stefantquach/steDAC/README.md

# SteDAC

Open source audio DAC project based on the ES9038Q2M DAC from ESS. Still WIP

# Credits
Logo art by @yumightaswell (Instagram)
