stefantquach/steDAC/panels/front_panel2_colored.dxf

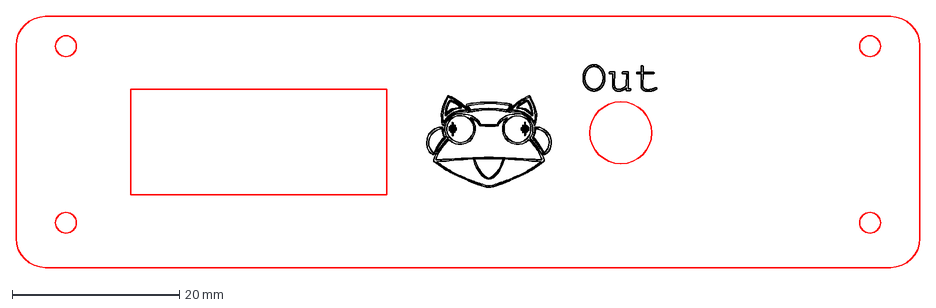
[picture p1: CAD file, 2022-07-17]
panels/front_panel2_colored.dxf
108.0 x 30.0 mm
