stefantquach/steDAC/panels/back_panel2_colored.dxf

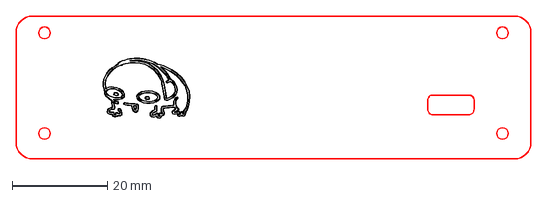
[picture p2: CAD file, 2022-07-17]
panels/back_panel2_colored.dxf
108.0 x 30.0 mm
