stefantquach/steDAC/KiCAD/pdf_sch/steDAC.pdf

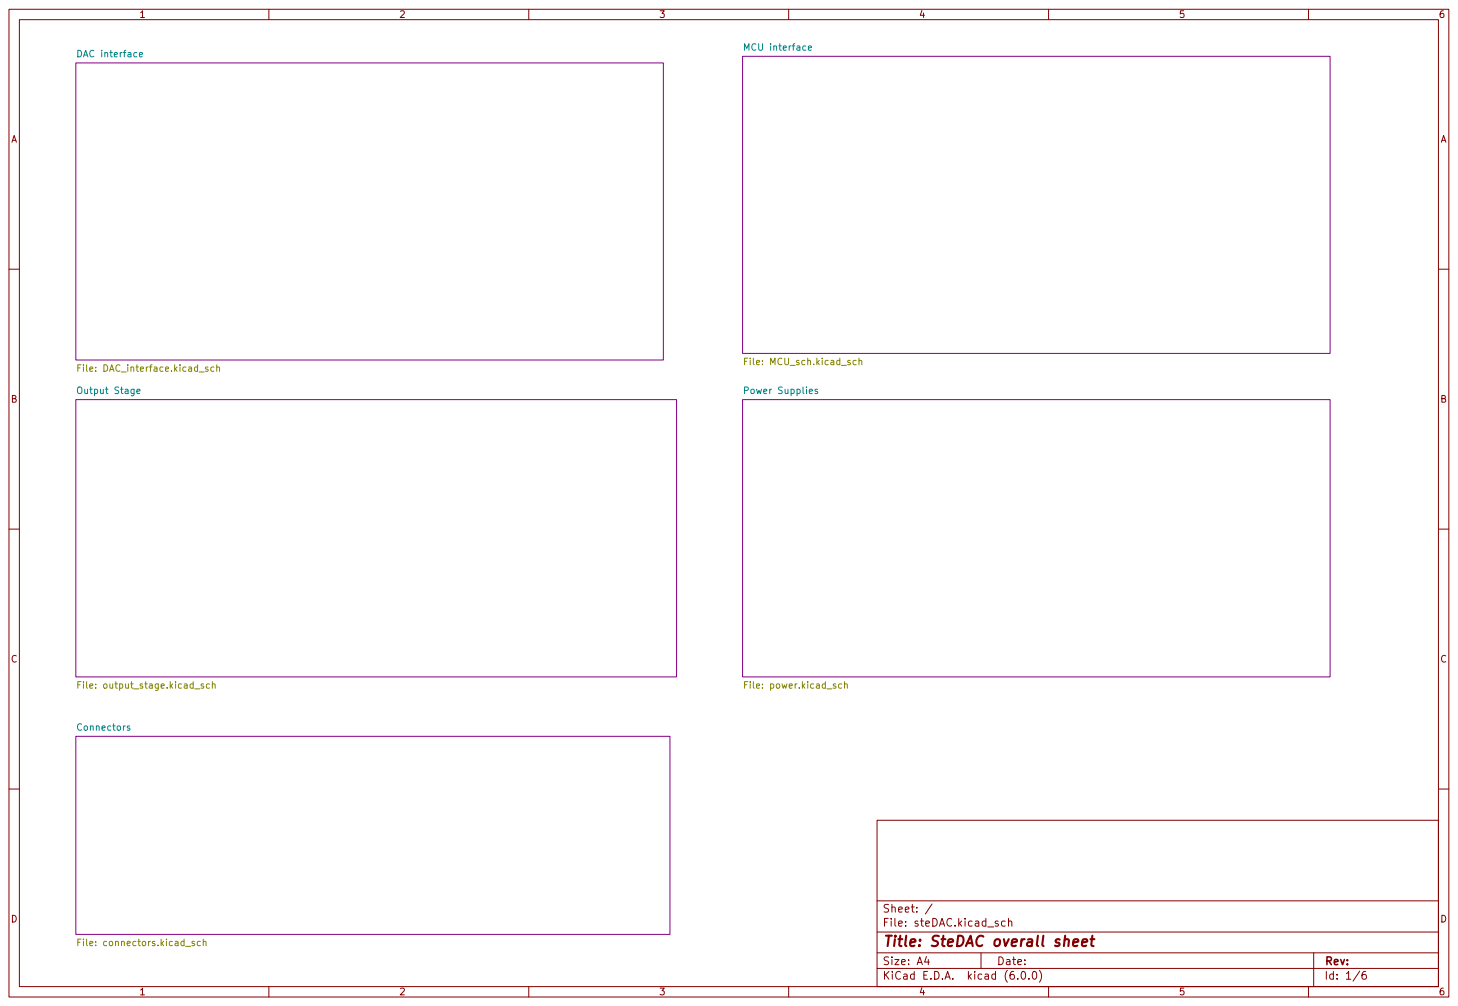
[picture p3: page 1]

MCU interface File: MCU_sch.kicad_sch Output Stage

File: output_stage.kicad_sch Connectors File: connectors.kicad_sch

File: steDAC.kicad_sch Sheet: /
Id: 1/6 Title: SteDAC overall sheet

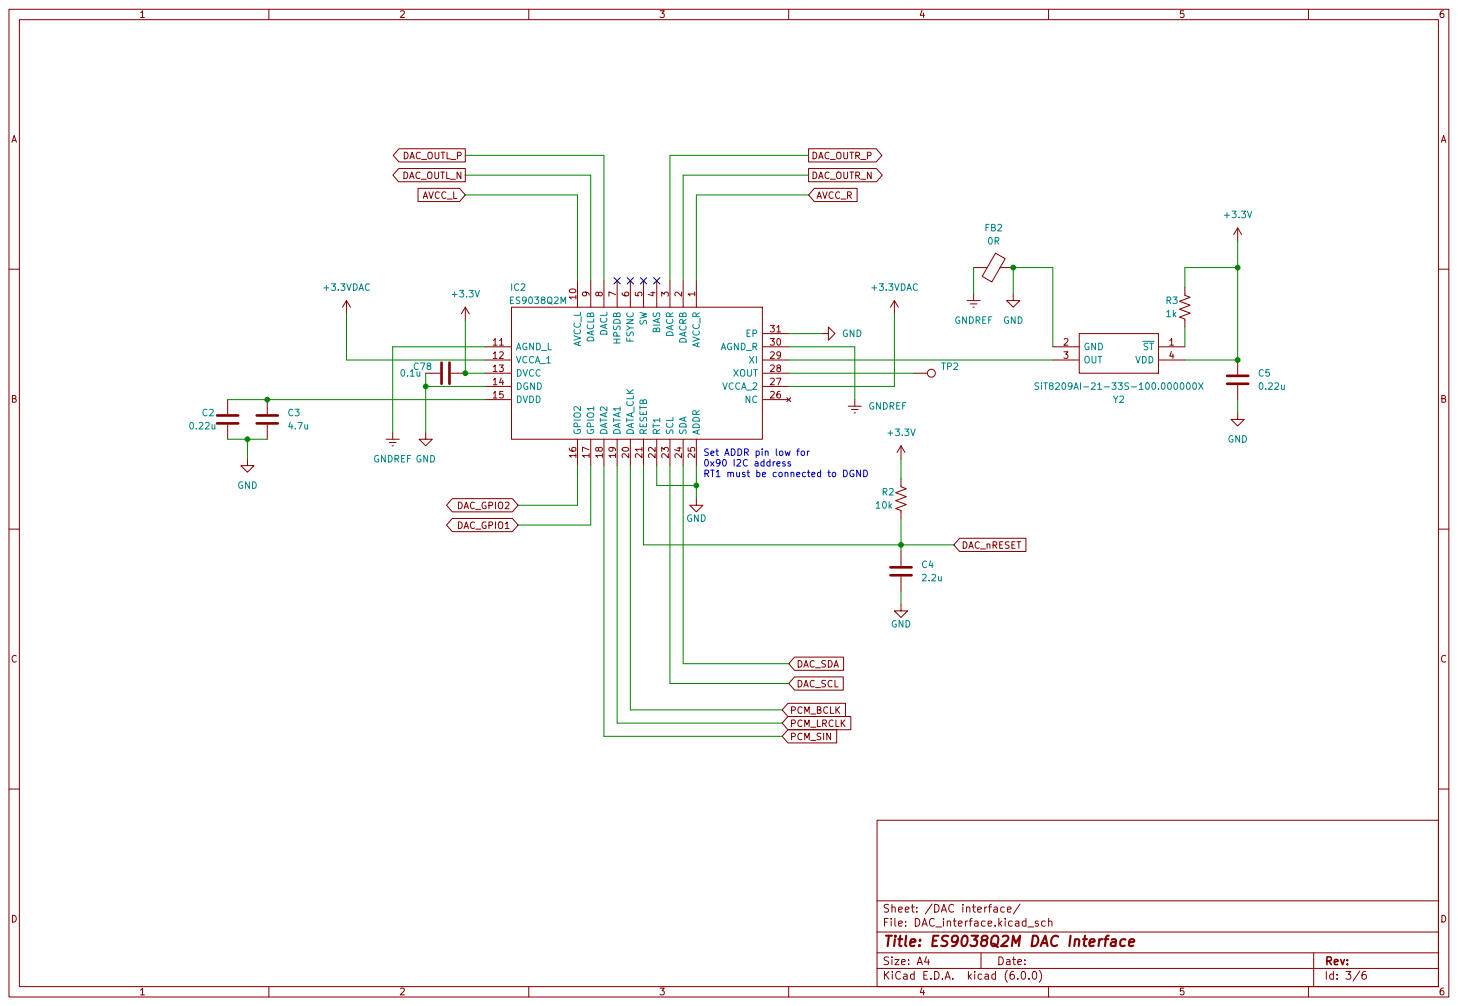
[picture p4: page 2]

1 AVCC_L 10 AGND_L 11 VCCA_1 12 DVCC 13 DGND 14 DVDD 15 GPIO2 16 GPIO1 17 DATA2 18 DATA1 19 DACRB

2 DATA_CLK 20 RESETB 21 RT1 22 SCL 23 SDA 24 ADDR 25 NC 26 VCCA_2 27 XOUT 28 XI 29 DACR

File: DAC_interface.kicad_sch Sheet: /DAC interface/
Id: 3/6 Title: ES9038Q2M DAC Interface

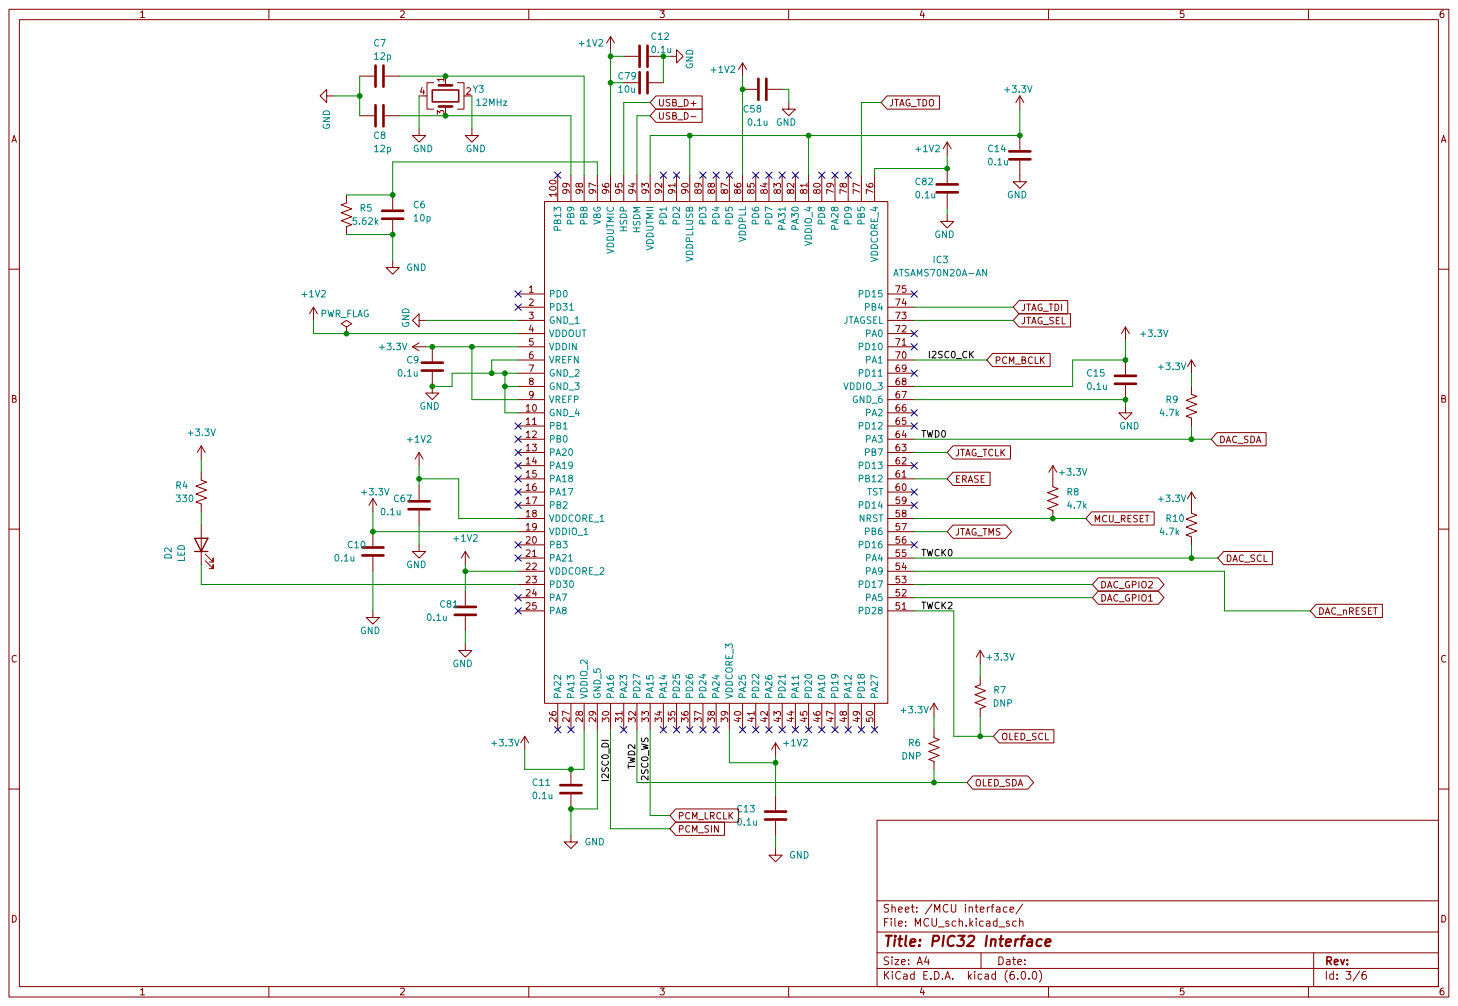
[picture p5: page 3]

File: MCU_sch.kicad_sch Sheet: /MCU interface/ +3.3V

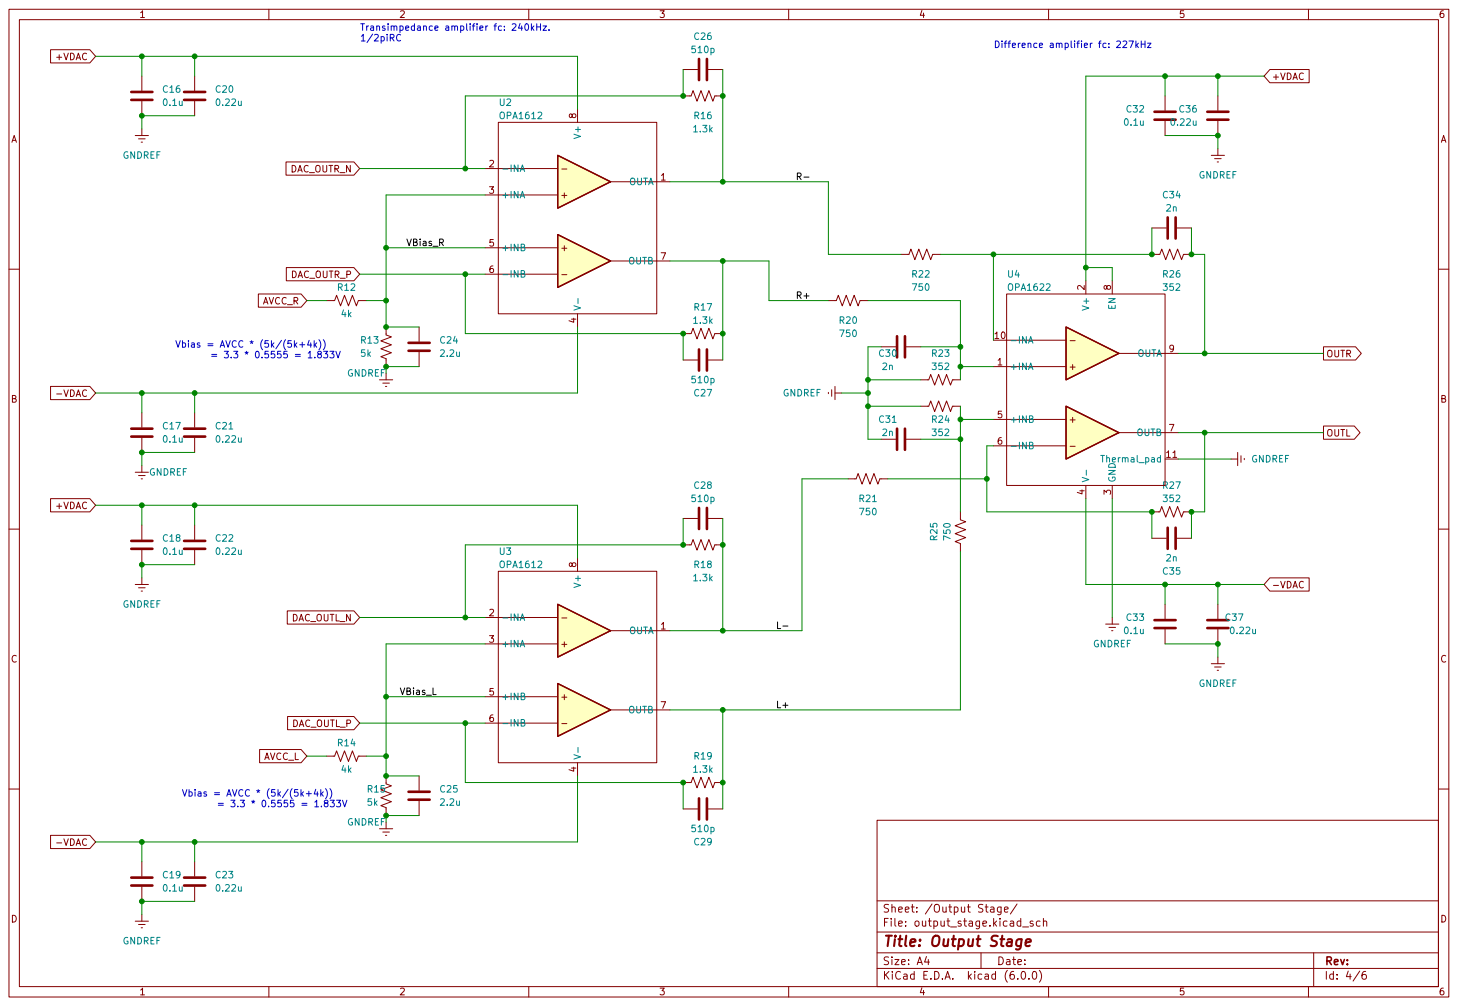
[picture p6: page 4]

File: output_stage.kicad_sch
Id: 4/6 Title: Output Stage

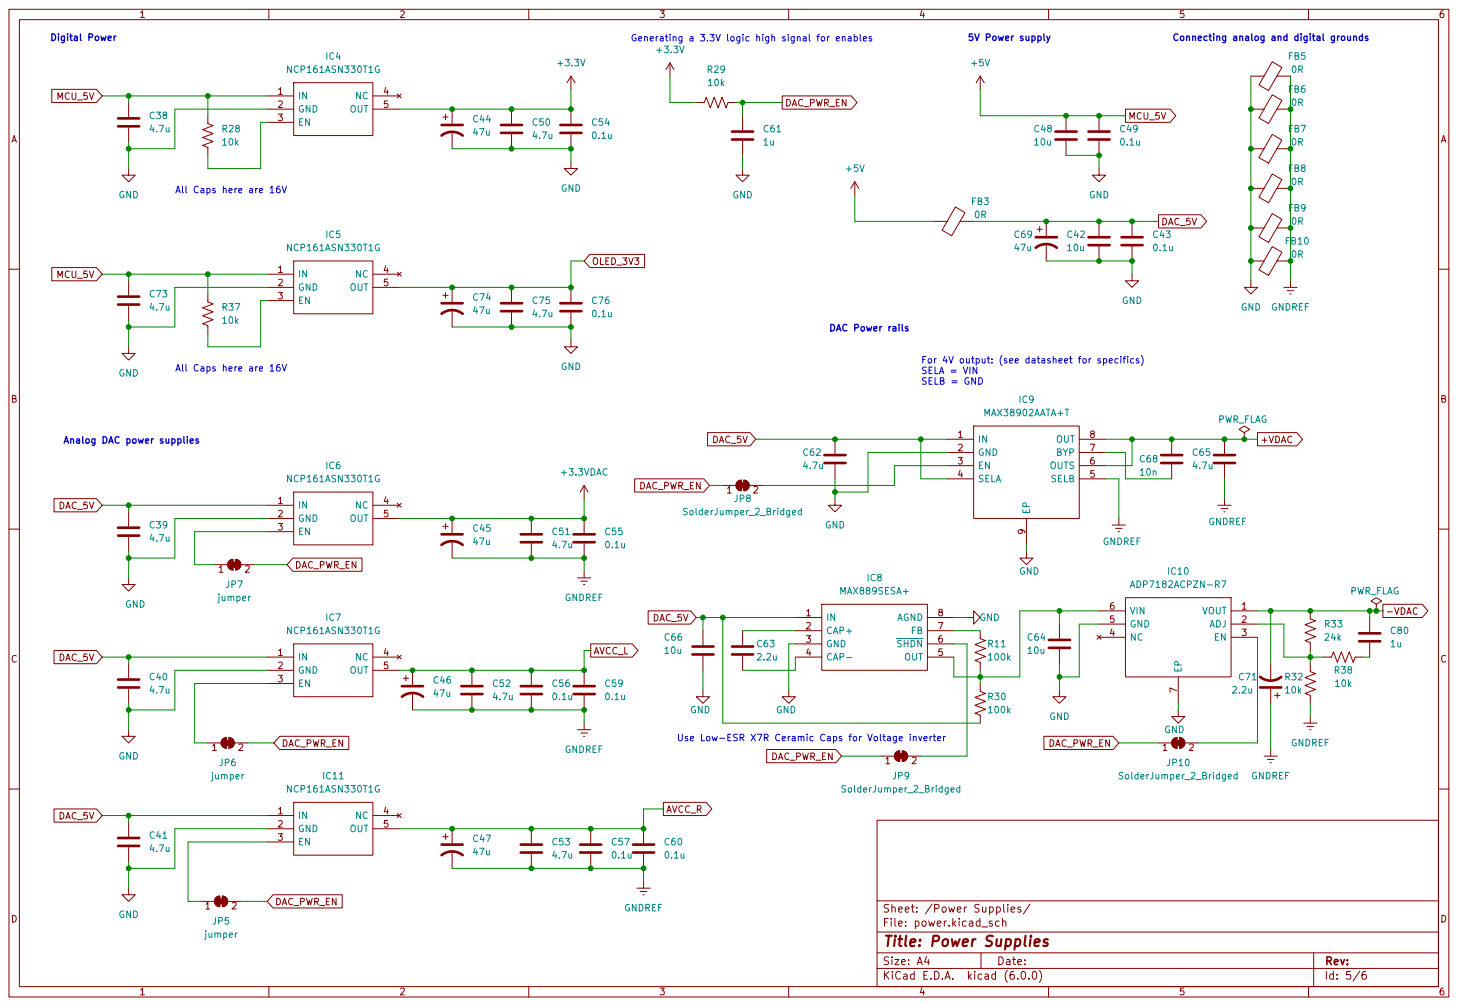
[picture p7: page 5]

All Caps here are 16V

Analog DAC power supplies
jumper C41

Sheet: /Power Supplies/
File: power.kicad_sch
Id: 5/6 Title: Power Supplies

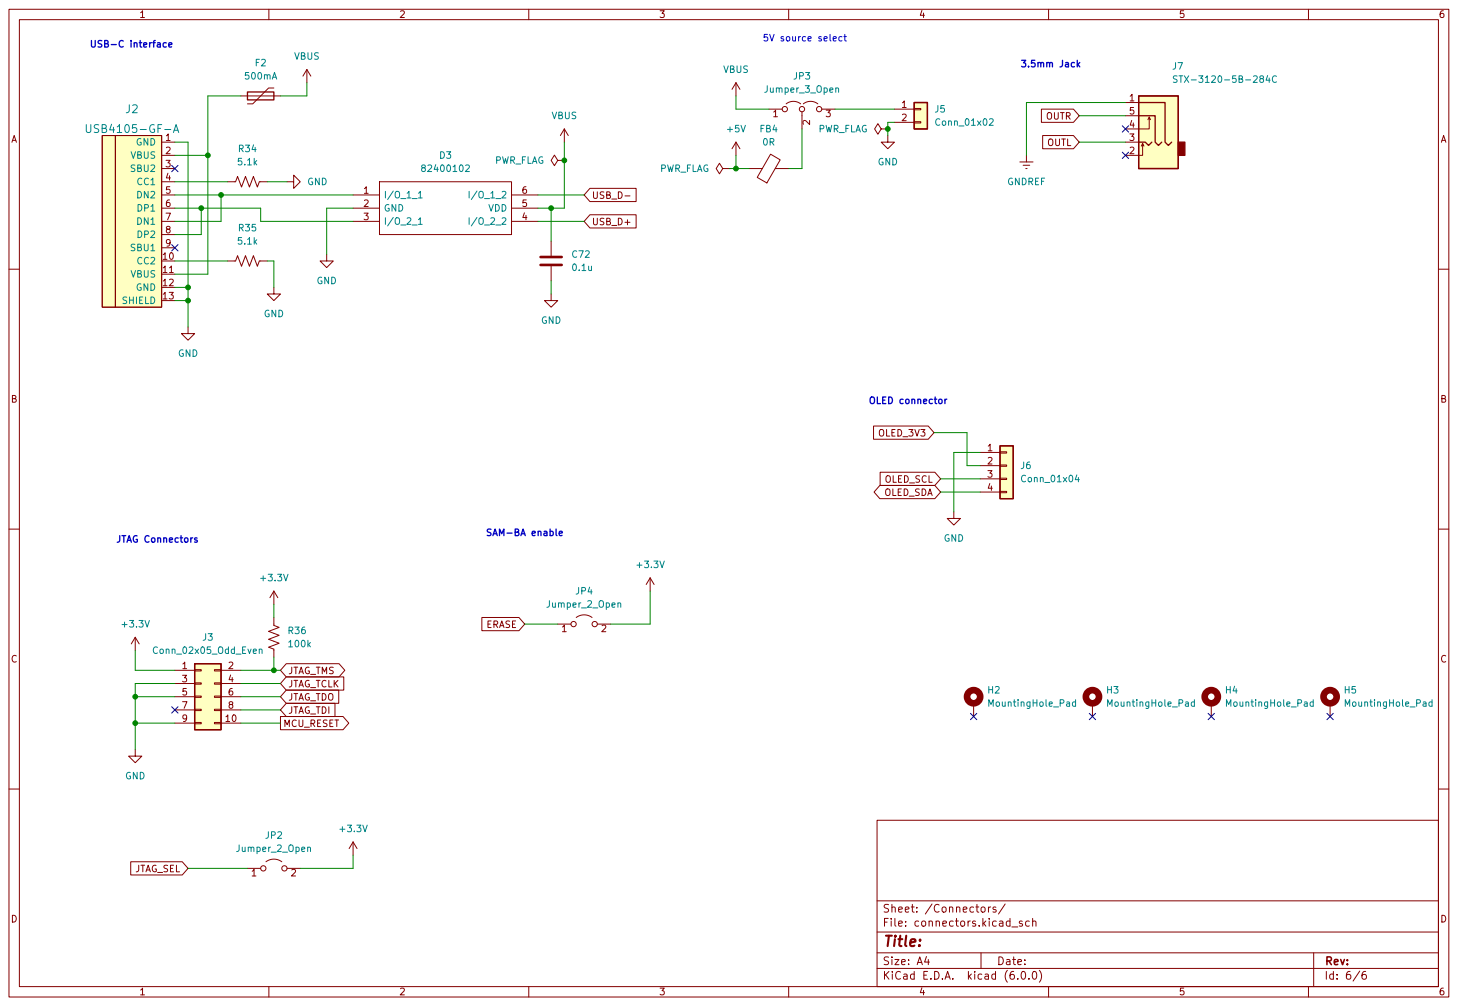
[picture p8: page 6]

3.5mm Jack SAM-BA enable
