stefantquach/steDAC/KiCAD/pdf_sch/steDAC-B_Cu.pdf

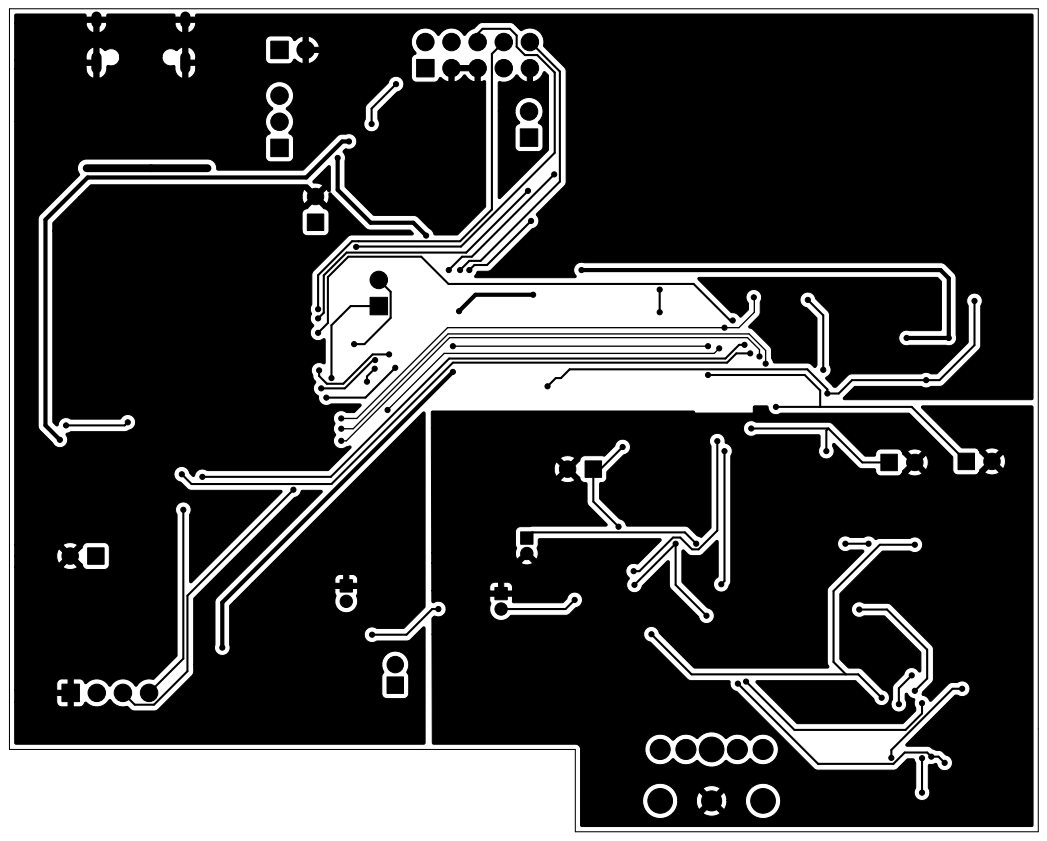
[picture p9: page 1]
