stefantquach/steDAC/KiCAD/pdf_sch/steDAC-B_Mask.pdf

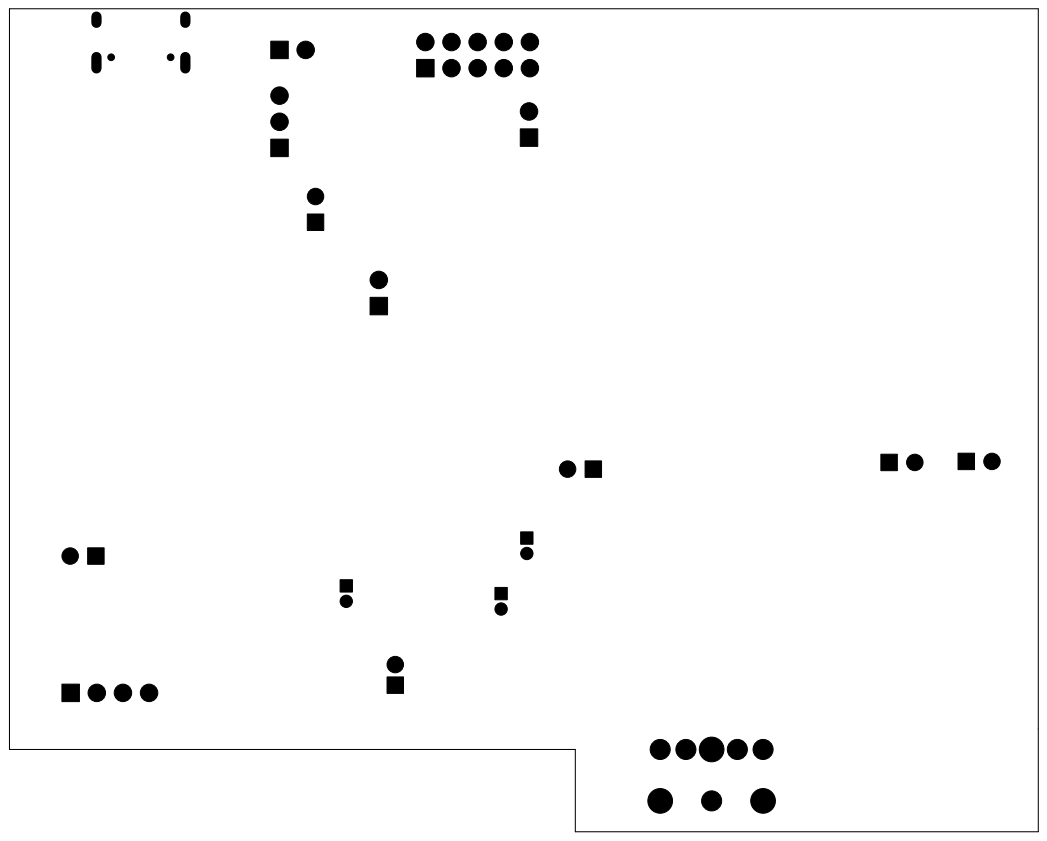
[picture p10: page 1]
