stefantquach/steDAC/KiCAD/pdf_sch/steDAC-F_Cu.pdf

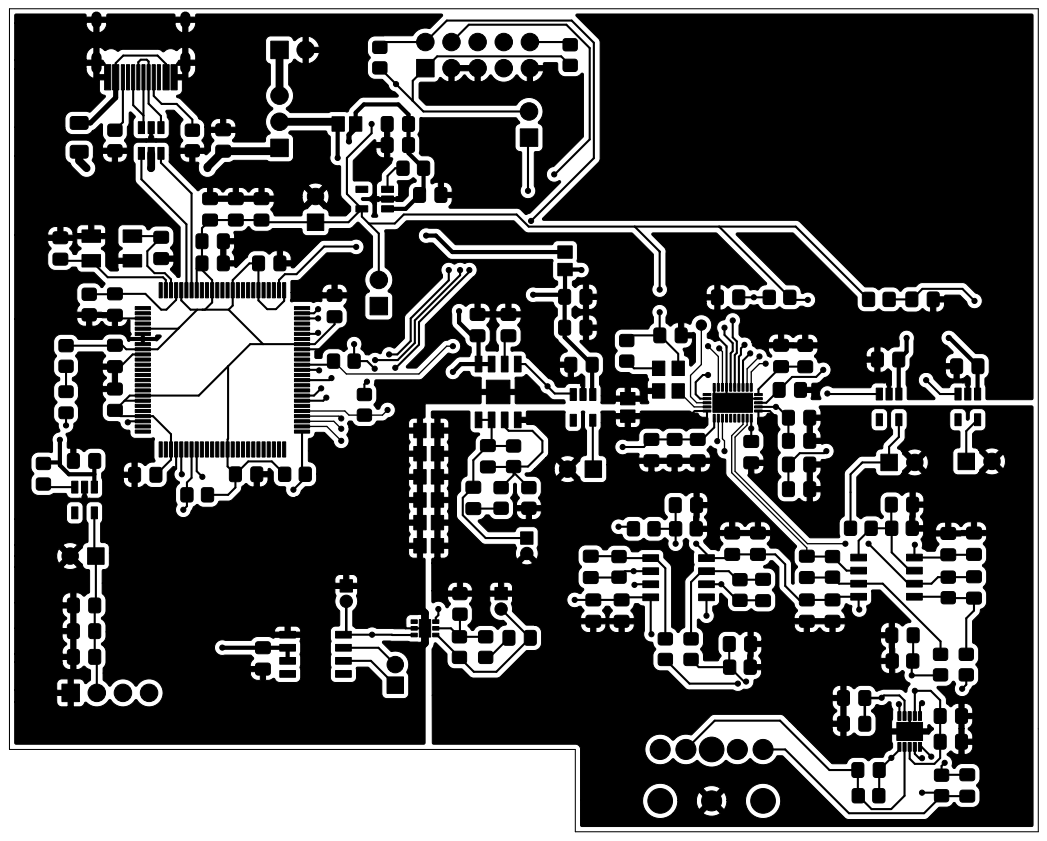
[picture p11: page 1]
