stefantquach/steDAC/KiCAD/pdf_sch/steDAC-F_Mask.pdf

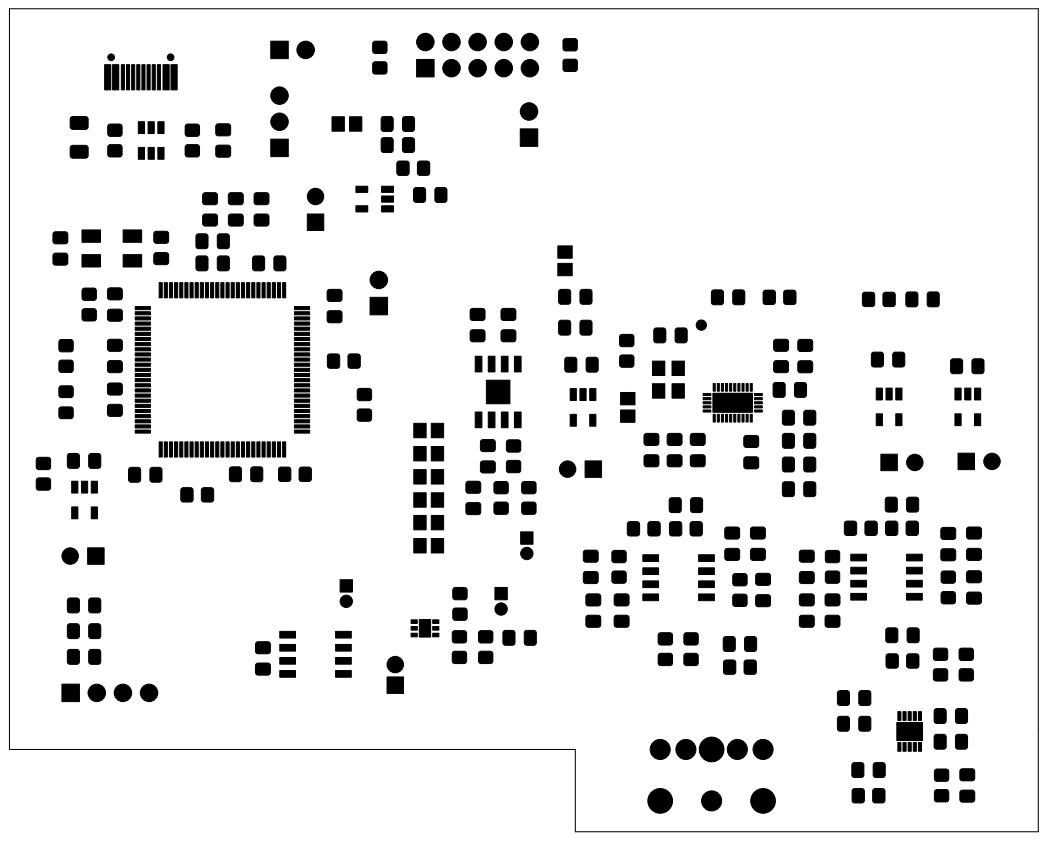
[picture p12: page 1]
