stefantquach/steDAC/KiCAD/pdf_sch/steDAC-F_Paste.pdf

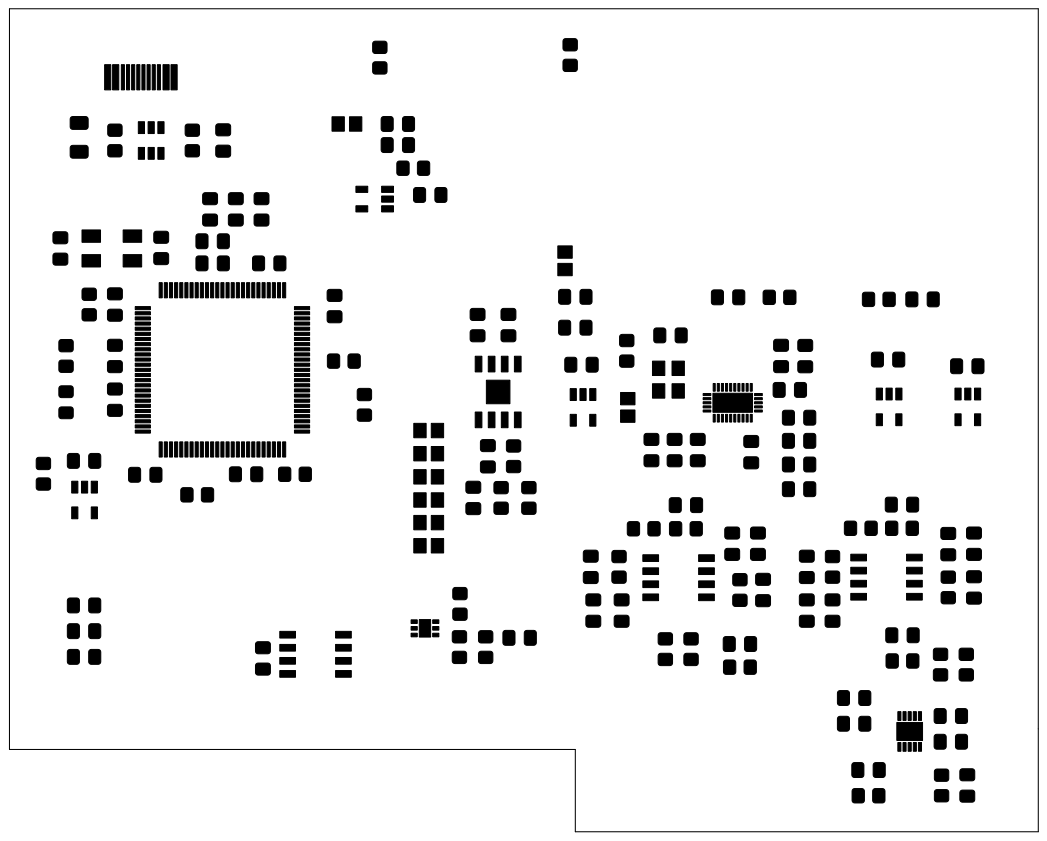
[picture p13: page 1]
