stefantquach/steDAC/KiCAD/pdf_sch/steDAC-F_Silkscreen.pdf

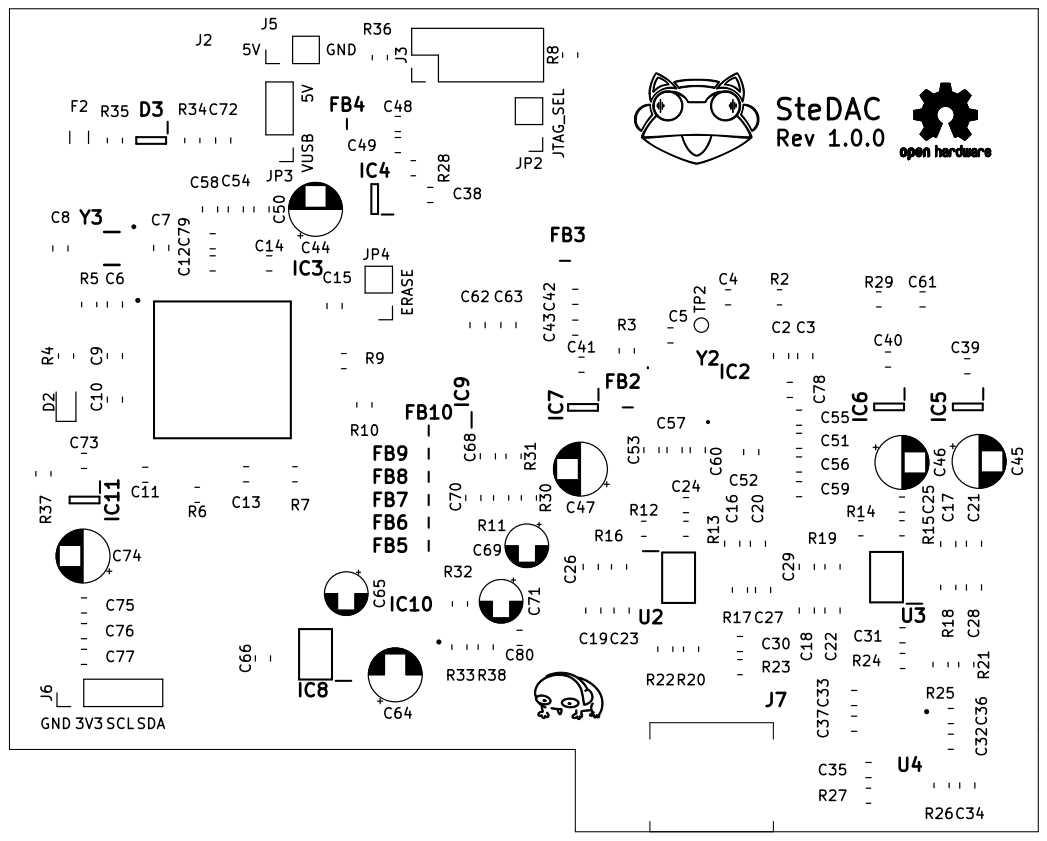
[picture p14: page 1]
