stefantquach/steDAC/KiCAD/steDAC.kicad_pcb

## KiCad design KiCAD/steDAC.kicad_pcb (2022-07-17)

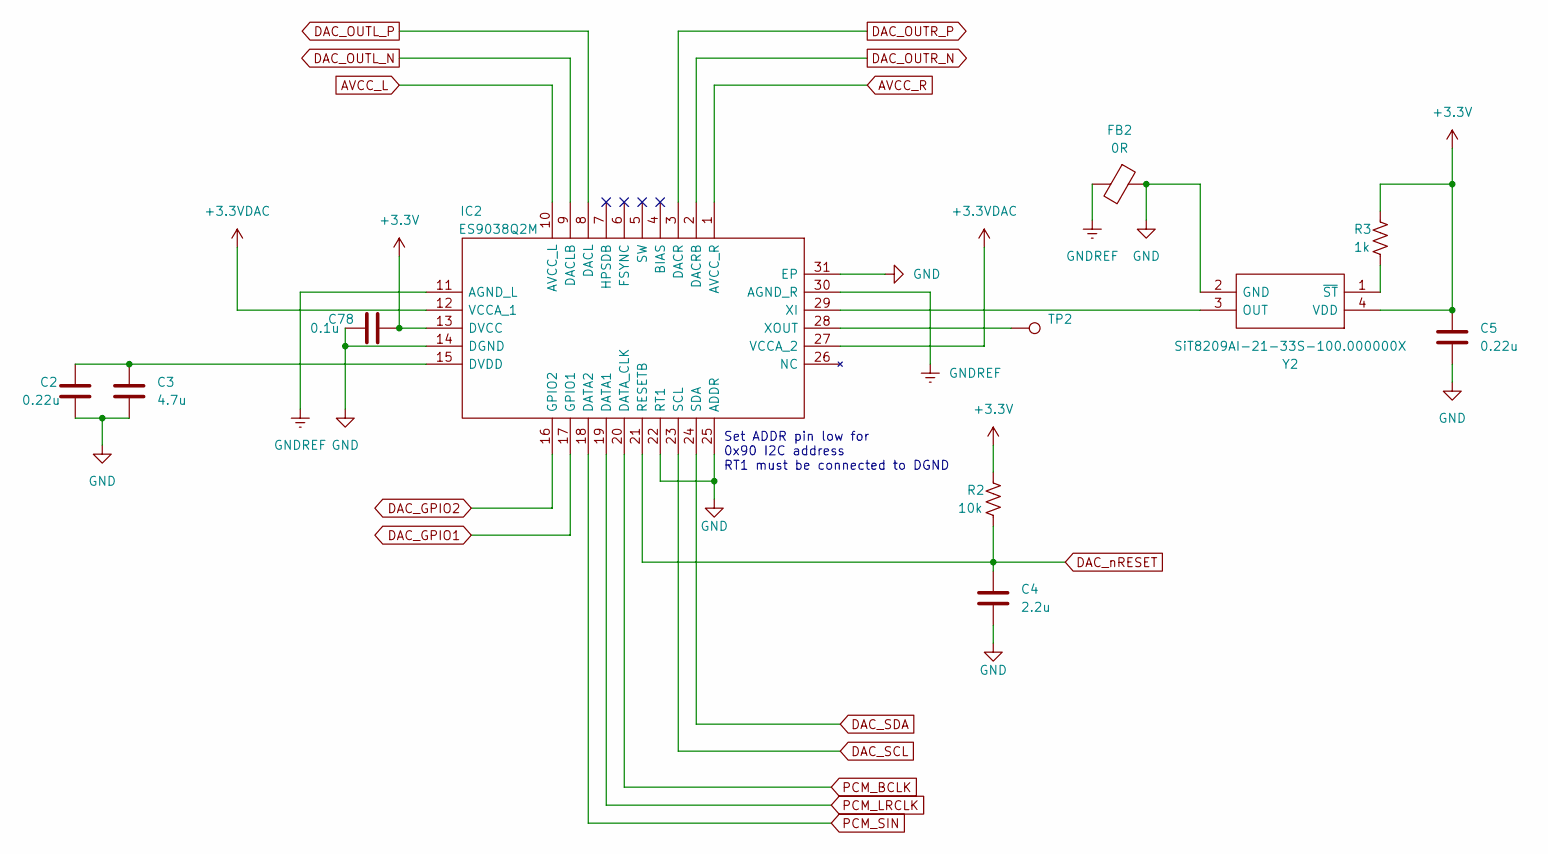
[picture p15: schematic DAC_interface.kicad_sch, ES9038Q2M DAC Interface]

Parts:
C2, C5: 0.22u; C_0805_2012Metric_Pad1.18x1.45mm_HandSolder; Part Number CL21B224KAFNNNG; Mouser Part Number 187-CL21B224KAFNNNG
C3: 4.7u; C_0805_2012Metric_Pad1.18x1.45mm_HandSolder; Part Number CC0805KKX5R7BB475; Mouser Part Number 603-CC805KKX5R7BB475
C4: 2.2u; C_0805_2012Metric_Pad1.18x1.45mm_HandSolder; Part Number TMK212B7225KGHT; Mouser Part Number 963-TMK212B7225KGHT
C78: 0.1u; C_0805_2012Metric_Pad1.18x1.45mm_HandSolder; Part Number CL21B104KBCNFNC; Mouser Part Number 187-CL21B104KBCNFNC
FB2: 0R; BEADC2012X110N; Part Number MFBW1V2012-000-R; Mouser Part Number 704-MFBW1V2012-000-R
IC2: ES9038Q2M; QFN40P300X500X80-31N-D; Manufacturer_Part_Number ES9038Q2M; Mouser Part Number 460-ES9038Q2M
R2: 10k; R_0805_2012Metric_Pad1.20x1.40mm_HandSolder; Part Number RC0805FR-7W10KL; Mouser Part Number 603-RC0805FR-7W10KL
R3: 1k; R_0805_2012Metric_Pad1.20x1.40mm_HandSolder; Part Number ERJ-HP6D1001V; Mouser Part Number 667-ERJ-HP6D1001V
TP2: TestPoint; TestPoint_Pad_D1.0mm
Y2: SiT8209AI-21-33S-100.000000X; SiT8209AI2133S100000000X; Manufacturer_Part_Number SiT8209AI-21-33S-100.000000X; Mouser Part Number 788-8209AI2133S-100X

Connections:
+3.3VDAC: IC2.12 (VCCA_1), IC2.27 (VCCA_2); also elsewhere on the board
+3V3: C5.1, C78.1, IC2.13 (DVCC), R2.1, R3.1, Y2.4 (VDD); also elsewhere on the board
AVCC_L: IC2.10 (AVCC_L); also elsewhere on the board
AVCC_R: IC2.1 (AVCC_R); also elsewhere on the board
DAC_GPIO1: IC2.17 (GPIO1); also elsewhere on the board
DAC_GPIO2: IC2.16 (GPIO2); also elsewhere on the board
DAC_OUTL_N: IC2.9 (DACLB); also elsewhere on the board
DAC_OUTL_P: IC2.8 (DACL); also elsewhere on the board
DAC_OUTR_N: IC2.2 (DACRB); also elsewhere on the board
DAC_OUTR_P: IC2.3 (DACR); also elsewhere on the board
DAC_SCL: IC2.23 (SCL); also elsewhere on the board
DAC_SDA: IC2.24 (SDA); also elsewhere on the board
DAC_nRESET: C4.1, IC2.21 (RESETB), R2.2; also elsewhere on the board
GND: C2.2, C3.2, C4.2, C5.2, C78.2, FB2.1, IC2.14 (DGND), IC2.22 (RT1), IC2.25 (ADDR), IC2.31 (EP), Y2.2 (GND); also elsewhere on the board
GNDREF: FB2.2, IC2.11 (AGND_L), IC2.30 (AGND_R); also elsewhere on the board
unnamed: C2.1, C3.1, IC2.15 (DVDD)
unnamed: IC2.28 (XOUT), TP2.1
unnamed: IC2.29 (XI), Y2.3 (OUT)
unnamed: R3.2, Y2.1 (~ST)
PCM_BCLK: IC2.20 (DATA_CLK); also elsewhere on the board
PCM_LRCLK: IC2.19 (DATA1); also elsewhere on the board
PCM_SIN: IC2.18 (DATA2); also elsewhere on the board

Notes on the sheet:
Set ADDR pin low for 0x90 I2C address RT1 must be connected to DGND

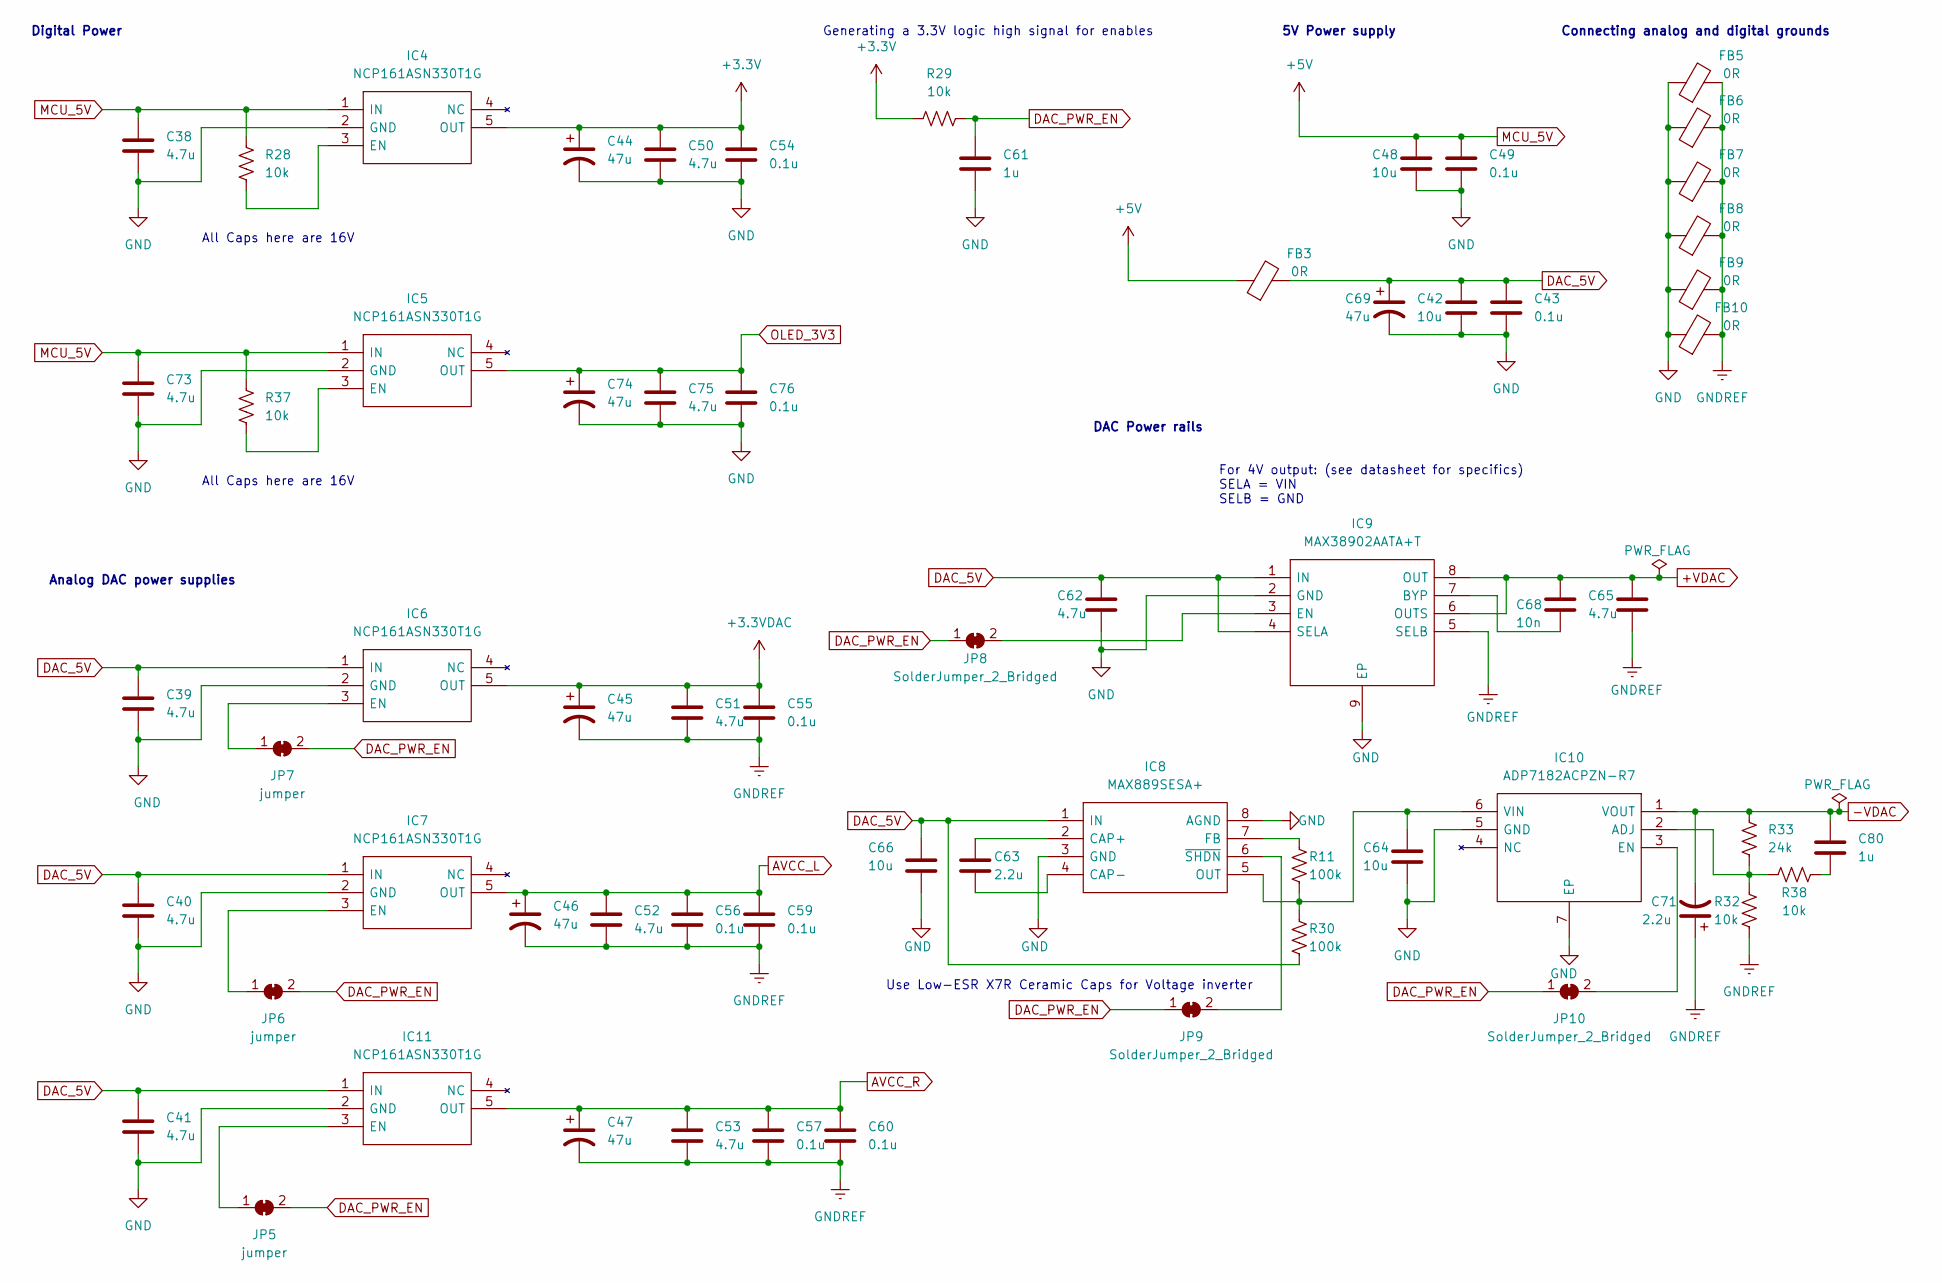
[picture p16: schematic power.kicad_sch, Power Supplies]

Parts:
C38, C39, C40, C41, C50, C51, C52, C53, C62, C65, C73, C75: 4.7u; C_0805_2012Metric_Pad1.18x1.45mm_HandSolder; Part Number CC0805KKX5R7BB475; Mouser Part Number 603-CC805KKX5R7BB475
C42, C48, C64, C66: 10u; C_0805_2012Metric_Pad1.18x1.45mm_HandSolder; Part Number TMK212BBJ106KG-T; Mouser Part Number 963-TMK212BBJ106KG-T
C43, C49, C54, C55, C56, C57, C59, C60, C76: 0.1u; C_0805_2012Metric_Pad1.18x1.45mm_HandSolder; Part Number CL21B104KBCNFNC; Mouser Part Number 187-CL21B104KBCNFNC
C44, C45, C46, C47, C69, C74: 47u; CP_Radial_D5.0mm_P2.50mm; Part Number ECA-1CHG470I; Mouser Part Number 667-ECA-1CHG470I
C61: 1u; C_0805_2012Metric_Pad1.18x1.45mm_HandSolder; Part Number EMK212B7105KG-T; Mouser Part Number 963-EMK212B7105KG-T
C63: 2.2u; C_0805_2012Metric_Pad1.18x1.45mm_HandSolder; Part Number TMK212B7225KGHT; Mouser Part Number 963-TMK212B7225KGHT
C68: 10n; C_0805_2012Metric_Pad1.18x1.45mm_HandSolder; Part Number C0805C103K4RECTU; Mouser Part Number 80-C0805C103K4RECTU
C71: 2.2u; CP_Radial_D4.0mm_P1.50mm; Part Number ECE-A1HKA2R2; Mouser Part Number 667-ECE-A1HKA2R2
C80: 1u; C_0805_2012Metric_Pad1.18x1.45mm_HandSolder; Mouser Part Number 963-EMK212B7105KG-T
FB3, FB5, FB6, FB7, FB8, FB9, FB10: 0R; BEADC2012X110N; Part Number MFBW1V2012-000-R; Mouser Part Number 704-MFBW1V2012-000-R
IC4, IC5, IC6, IC7, IC11: NCP161ASN330T1G; SOT95P280X145-5N; Manufacturer_Part_Number NCP161ASN330T1G; Mouser Part Number 863-NCP161ASN330T1G
IC8: MAX889SESA+; SOIC127P600X175-8N; Manufacturer_Part_Number MAX889SESA+; Mouser Part Number 700-MAX889SESA
IC9: MAX38902AATA+T; SON50P200X200X80-9N-D; Manufacturer_Part_Number MAX38902AATA+T; Mouser Part Number 700-MAX38902AATA+T
IC10: ADP7182ACPZN-R7; SON65P200X200X65-7N-D; Manufacturer_Part_Number ADP7182ACPZN-R7; Mouser Part Number 584-ADP7182ACPZN-R7
JP5, JP6, JP7: jumper; SolderJumper-2_P1.3mm_Bridged2Bar_Pad1.0x1.5mm
JP8, JP9, JP10: SolderJumper_2_Bridged; SolderJumper-2_P1.3mm_Bridged2Bar_Pad1.0x1.5mm
R11, R30: 100k; R_0805_2012Metric_Pad1.20x1.40mm_HandSolder; Part Number RCV0805100KJNEA; Mouser Part Number 71-RCV0805100KJNEA
R28, R29, R37: 10k; R_0805_2012Metric_Pad1.20x1.40mm_HandSolder; Part Number RC0805FR-7W10KL; Mouser Part Number 603-RC0805FR-7W10KL
R32, R38: 10k; R_0805_2012Metric_Pad1.20x1.40mm_HandSolder; Part Number RT0805BRD0710KL; Mouser Part Number 603-RT0805BRD0710KL
R33: 24k; R_0805_2012Metric_Pad1.20x1.40mm_HandSolder; Part Number ERA-6AEB243V; Mouser Part Number 667-ERA-6AEB243V

Connections:
+3.3VDAC: C45.1, C51.1, C55.1, IC6.5 (OUT); also elsewhere on the board
+3V3: C44.1, C50.1, C54.1, IC4.5 (OUT), R29.1; also elsewhere on the board
+VDAC: C65.1, C68.1, IC9.6 (OUTS), IC9.8 (OUT); also elsewhere on the board
-VDAC: C71.2, C80.1, IC10.1 (VOUT), R33.2; also elsewhere on the board
AVCC_L: C46.1, C52.1, C56.1, C59.1, IC7.5 (OUT); also elsewhere on the board
AVCC_R: C47.1, C53.1, C57.1, C60.1, IC11.5 (OUT); also elsewhere on the board
DAC_5V: C39.1, C40.1, C41.1, C42.2, C43.1, C62.1, C66.1, C69.1, FB3.2, IC6.1 (IN), IC7.1 (IN), IC8.1 (IN), IC9.1 (IN), IC9.4 (SELA), IC11.1 (IN), R30.1
DAC_PWR_EN: C61.1, JP5.2 (B), JP6.2 (B), JP7.2 (B), JP8.1 (A), JP9.1 (A), JP10.1 (A), R29.2
GND: C38.2, C39.2, C40.2, C41.2, C42.1, C43.2, C44.2, C48.1, C49.2, C50.2, C54.2, C61.2, C62.2, C64.2, C66.2, C69.2, C73.2, C74.2, C75.2, C76.2, FB5.1, FB6.1, FB7.1, FB8.1, FB9.1, FB10.1, IC4.2 (GND), IC5.2 (GND), IC6.2 (GND), IC7.2 (GND), IC8.3 (GND), IC8.8 (AGND), IC9.2 (GND), IC9.9 (EP), IC10.5 (GND), IC10.7 (EP), IC11.2 (GND); also elsewhere on the board
GNDREF: C45.2, C46.2, C47.2, C51.2, C52.2, C53.2, C55.2, C56.2, C57.2, C59.2, C60.2, C65.2, C71.1, FB5.2, FB6.2, FB7.2, FB8.2, FB9.2, FB10.2, IC9.5 (SELB), R32.1; also elsewhere on the board
MCU_5V: C38.1, C48.2, C49.1, C73.1, FB3.1, IC4.1 (IN), IC5.1 (IN), R28.2, R37.2; also elsewhere on the board
unnamed: C63.1, IC8.2 (CAP+)
unnamed: C63.2, IC8.4 (CAP-)
unnamed: C64.1, IC8.5 (OUT), IC10.6 (VIN), R11.1, R30.2
unnamed: C68.2, IC9.7 (BYP)
unnamed: C80.2, R38.1
unnamed: IC4.3 (EN), R28.1
unnamed: IC5.3 (EN), R37.1
unnamed: IC6.3 (EN), JP7.1 (A)
unnamed: IC7.3 (EN), JP6.1 (A)
unnamed: IC8.6 (~SHDN), JP9.2 (B)
unnamed: IC8.7 (FB), R11.2
unnamed: IC9.3 (EN), JP8.2 (B)
unnamed: IC10.2 (ADJ), R32.2, R33.1, R38.2
unnamed: IC10.3 (EN), JP10.2 (B)
unnamed: IC11.3 (EN), JP5.1 (A)
OLED_3V3: C74.1, C75.1, C76.1, IC5.5 (OUT); also elsewhere on the board

Notes on the sheet:
DAC Power rails
Connecting analog and digital grounds
For 4V output: (see datasheet for specifics) SELA = VIN SELB = GND
Digital Power
Analog DAC power supplies
Generating a 3.3V logic high signal for enables
Use Low-ESR X7R Ceramic Caps for Voltage inverter
All Caps here are 16V
5V Power supply

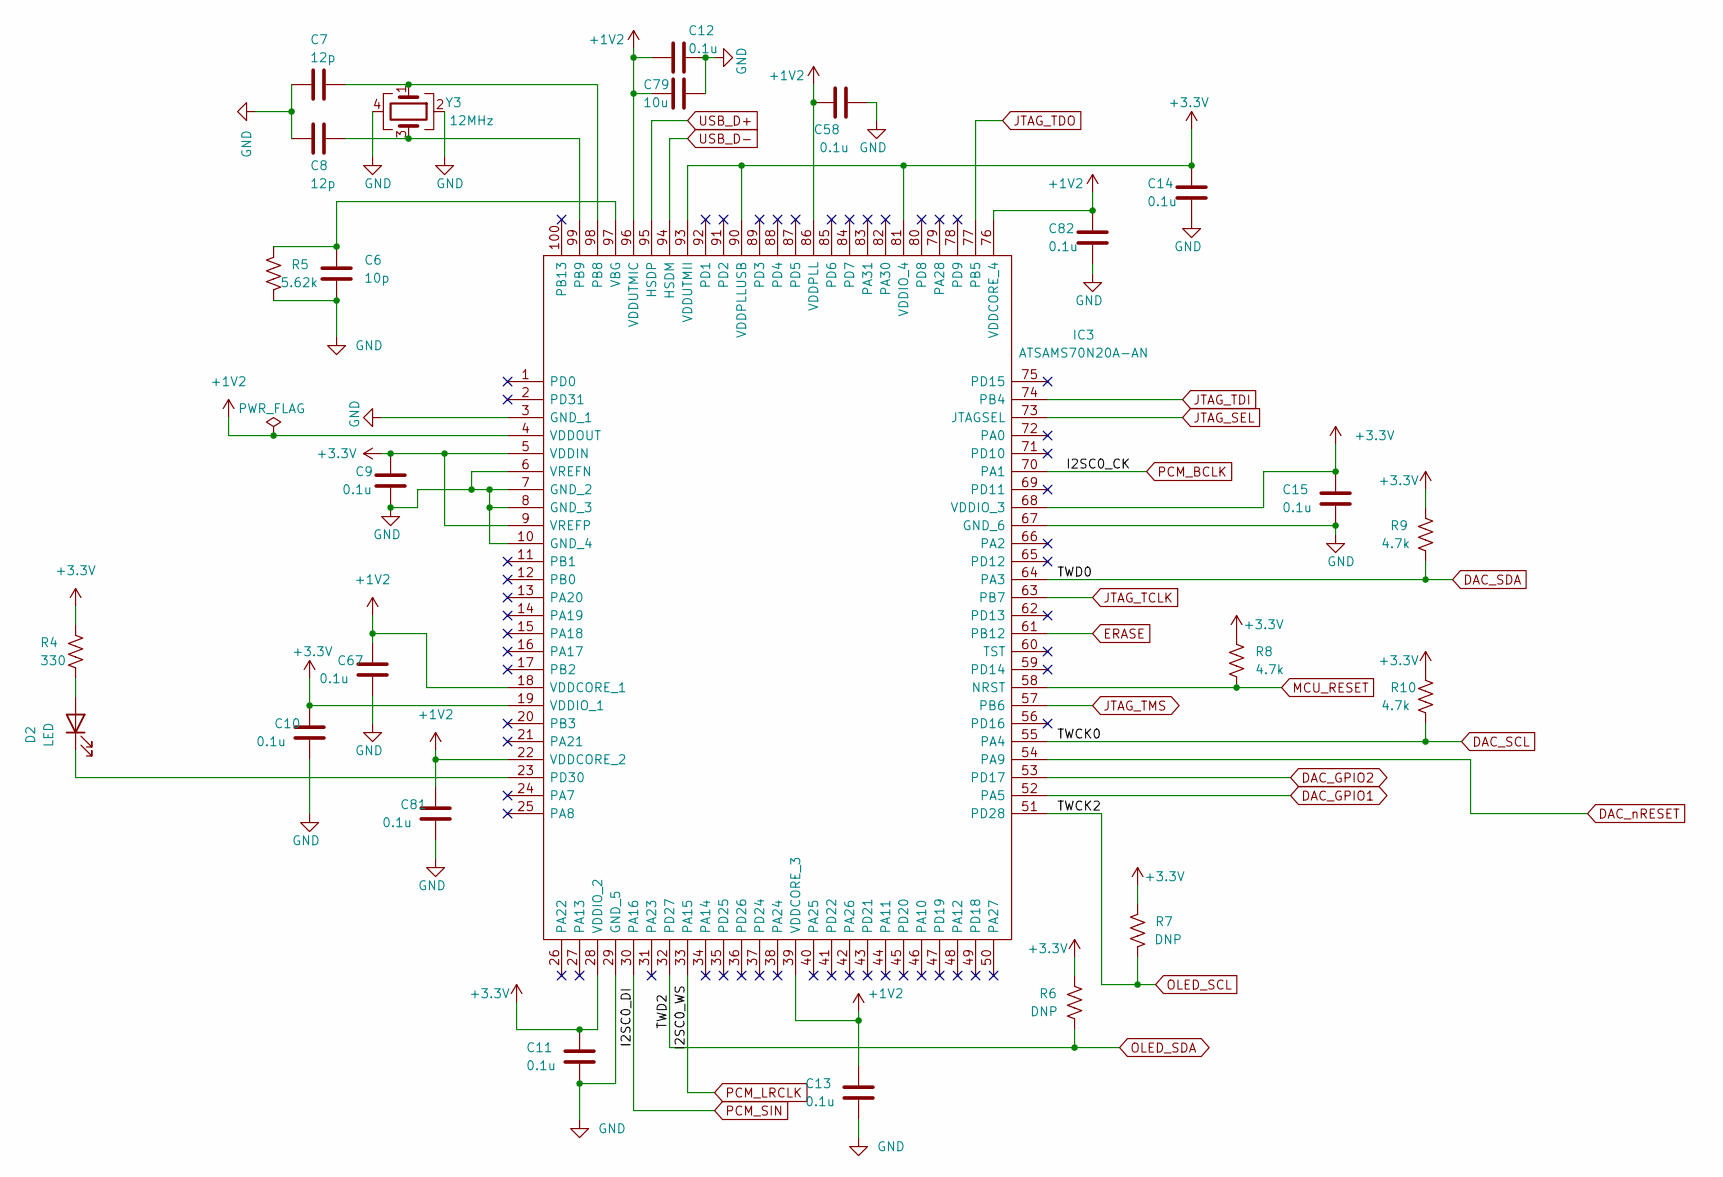
[picture p17: schematic MCU_sch.kicad_sch, PIC32 Interface]

Parts:
C6: 10p; C_0805_2012Metric_Pad1.18x1.45mm_HandSolder; Part Number VJ0805A100GXJCW1BC; Mouser Part Number 77-VJ0805A100GXJCBC
C7, C8: 12p; C_0805_2012Metric_Pad1.18x1.45mm_HandSolder; Part Number C0805C120J8GACTU; Mouser Part Number 80-C0805C120J8G
C9, C10, C11, C12, C13, C14, C15, C58, C67, C81, C82: 0.1u; C_0805_2012Metric_Pad1.18x1.45mm_HandSolder; Part Number CL21B104KBCNFNC; Mouser Part Number 187-CL21B104KBCNFNC
C79: 10u; C_0805_2012Metric_Pad1.18x1.45mm_HandSolder; Part Number TMK212BBJ106KG-T; Mouser Part Number 963-TMK212BBJ106KG-T
D2: LED; LED_0805_2012Metric_Pad1.15x1.40mm_HandSolder; Part Number SM0805PGC; Mouser Part Number 749-SM0805PGC
IC3: ATSAMS70N20A-AN; QFP50P1600X1600X160-100N; Manufacturer_Part_Number ATSAMS70N20A-AN; Mouser Part Number 556-ATSAMS70N20A-AN
R4: 330; R_0805_2012Metric_Pad1.20x1.40mm_HandSolder; Part Number CMP0805-FX-3300ELF; Mouser Part Number 652-CMP0805-FX-3300L
R5: 5.62k; R_0805_2012Metric_Pad1.20x1.40mm_HandSolder; Part Number CRCW08055K62FKEAC; Mouser Part Number 71-CRCW08055K62FKEAC
R6, R7: DNP; R_0805_2012Metric_Pad1.20x1.40mm_HandSolder
R8, R9, R10: 4.7k; R_0805_2012Metric_Pad1.20x1.40mm_HandSolder; Part Number ERJ-P06J472V; Mouser Part Number 667-ERJ-P06J472V
Y3: 12MHz; ABM3B; Part Number ABM3B-12.000MHZ-12-N2Y-T; Mouser Part Number 815-ABM3B12MHZ12N2YT

Connections:
+1V2: C12.2, C13.1, C58.1, C67.1, C79.2, C81.1, C82.1, IC3.4 (VDDOUT), IC3.18 (VDDCORE_1), IC3.22 (VDDCORE_2), IC3.39 (VDDCORE_3), IC3.76 (VDDCORE_4), IC3.86 (VDDPLL), IC3.96 (VDDUTMIC)
+3V3: C9.1, C10.1, C11.1, C14.1, C15.1, IC3.5 (VDDIN), IC3.9 (VREFP), IC3.19 (VDDIO_1), IC3.28 (VDDIO_2), IC3.68 (VDDIO_3), IC3.81 (VDDIO_4), IC3.90 (VDDPLLUSB), IC3.93 (VDDUTMII), R4.1, R6.1, R7.1, R8.1, R9.1, R10.1; also elsewhere on the board
DAC_GPIO1: IC3.52 (PA5); also elsewhere on the board
DAC_GPIO2: IC3.53 (PD17); also elsewhere on the board
DAC_SCL: IC3.55 (PA4), R10.2; also elsewhere on the board
DAC_SDA: IC3.64 (PA3), R9.2; also elsewhere on the board
DAC_nRESET: IC3.54 (PA9); also elsewhere on the board
ERASE: IC3.61 (PB12); also elsewhere on the board
GND: C6.2, C7.2, C8.2, C9.2, C10.2, C11.2, C12.1, C13.2, C14.2, C15.2, C58.2, C67.2, C79.1, C81.2, C82.2, IC3.3 (GND_1), IC3.6 (VREFN), IC3.7 (GND_2), IC3.8 (GND_3), IC3.10 (GND_4), IC3.29 (GND_5), IC3.67 (GND_6), R5.2, Y3.2, Y3.4; also elsewhere on the board
JTAG_SEL: IC3.73 (JTAGSEL); also elsewhere on the board
JTAG_TCLK: IC3.63 (PB7); also elsewhere on the board
JTAG_TDI: IC3.74 (PB4); also elsewhere on the board
JTAG_TDO: IC3.77 (PB5); also elsewhere on the board
JTAG_TMS: IC3.57 (PB6); also elsewhere on the board
MCU_RESET: IC3.58 (NRST), R8.2; also elsewhere on the board
unnamed: C6.1, IC3.97 (VBG), R5.1
unnamed: C7.1, IC3.98 (PB8), Y3.1
unnamed: C8.1, IC3.99 (PB9), Y3.3
unnamed: D2.1 (K), IC3.23 (PD30)
unnamed: D2.2 (A), R4.2
OLED_SCL: IC3.51 (PD28), R7.2; also elsewhere on the board
OLED_SDA: IC3.32 (PD27), R6.2; also elsewhere on the board
PCM_BCLK: IC3.70 (PA1); also elsewhere on the board
PCM_LRCLK: IC3.33 (PA15); also elsewhere on the board
PCM_SIN: IC3.30 (PA16); also elsewhere on the board
USB_D+: IC3.95 (HSDP); also elsewhere on the board
USB_D-: IC3.94 (HSDM); also elsewhere on the board

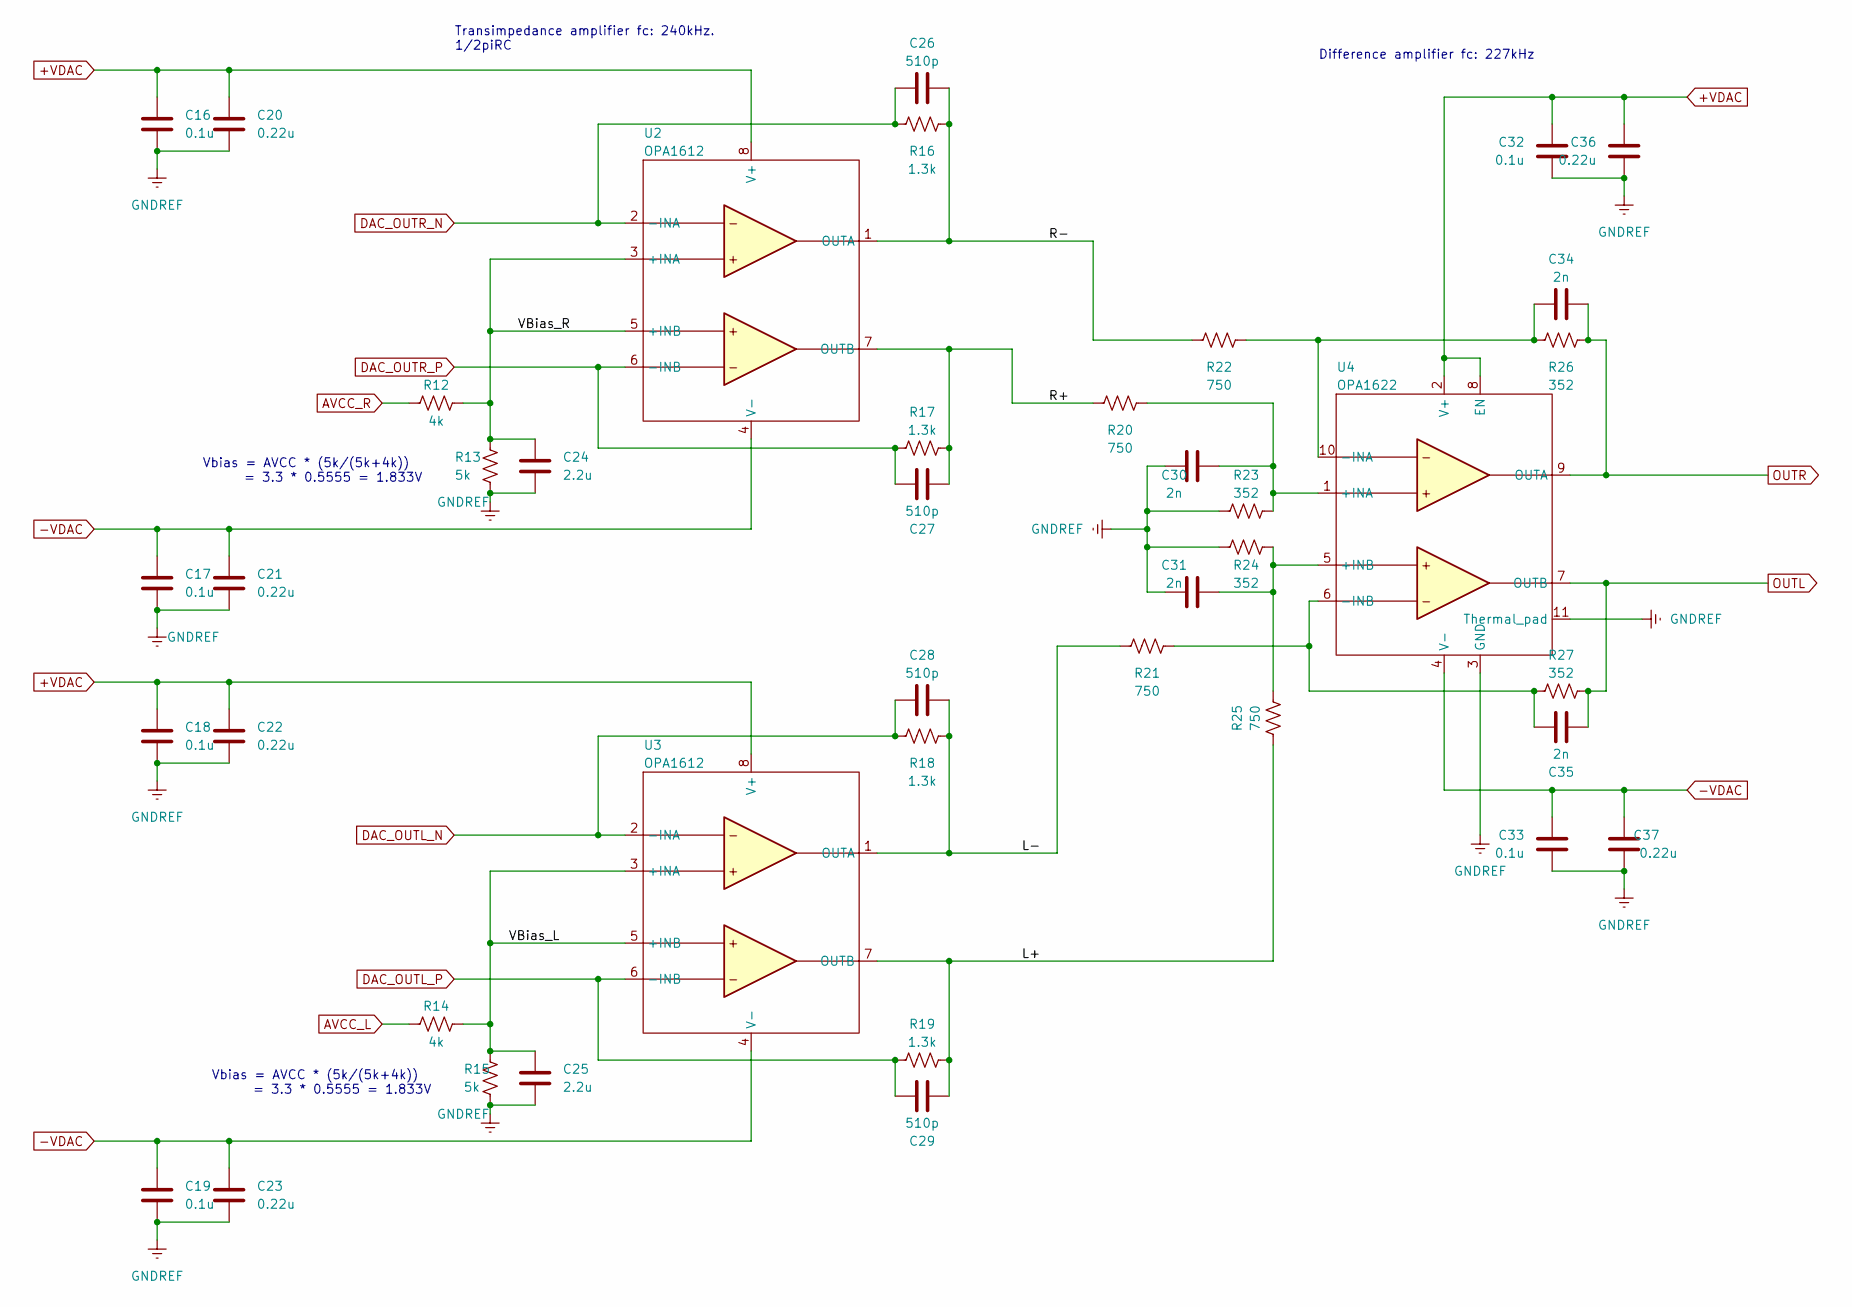
[picture p18: schematic output_stage.kicad_sch, Output Stage]

Parts:
C16, C17, C18, C19: 0.1u; C_0805_2012Metric_Pad1.18x1.45mm_HandSolder; Part Number CL21B104KBCNFNC; Mouser Part Number 187-CL21B104KBCNFNC
C20, C21, C22, C23, C36, C37: 0.22u; C_0805_2012Metric_Pad1.18x1.45mm_HandSolder; Part Number CL21B224KAFNNNG; Mouser Part Number 187-CL21B224KAFNNNG
C24, C25: 2.2u; C_0805_2012Metric_Pad1.18x1.45mm_HandSolder; Part Number TMK212B7225KGHT; Mouser Part Number 963-TMK212B7225KGHT
C26, C27, C28, C29: 510p; C_0805_2012Metric_Pad1.18x1.45mm_HandSolder; Part Number C0805C511F3HACTU; Mouser Part Number 80-C0805C511F3HACTU
C30, C31, C34, C35: 2n; C_0805_2012Metric_Pad1.18x1.45mm_HandSolder; Part Number C0805C202F4HACAUTO; Mouser Part Number 80-C0805C202F4HAUTO
C32, C33: 0.1u; C_0805_2012Metric_Pad1.18x1.45mm_HandSolder; Mouser Part Number 187-CL21B104KBCNFNC
R12, R14: 4k; R_0805_2012Metric_Pad1.20x1.40mm_HandSolder; Part Number TNPW08054K02BYEN; Mouser Part Number 71-TNPW08054K02BYEN
R13, R15: 5k; R_0805_2012Metric_Pad1.20x1.40mm_HandSolder; Part Number CRT0805-BY-5001EAS; Mouser Part Number 652-CRT0805BY5001EAS
R16, R17, R18, R19: 1.3k; R_0805_2012Metric_Pad1.20x1.40mm_HandSolder; Part Number RG2012P-132-B-T5; Mouser Part Number 754-RG2012P-132-BT5
R20, R21, R22, R25: 750; R_0805_2012Metric_Pad1.20x1.40mm_HandSolder; Part Number TNPW0805750RBEEA; Mouser Part Number 71-TNPW0805750RBEEA
R23, R24, R26, R27: 352; R_0805_2012Metric_Pad1.20x1.40mm_HandSolder; Part Number RN73H2ATTD3520B25; Mouser Part Number 660-RN73H2ATD3520B25
U2, U3: OPA1612; SOIC127P600X175-8N; Part Number OPA1612AID; Mouser Part Number 595-OPA1612AID
U4: OPA1622; SON50P300X300X100-11N; Manufacturer_Part_Number OPA1622IDRCR; Mouser Part Number 595-OPA1622IDRCR

Connections:
+VDAC: C16.2, C18.2, C20.2, C22.2, C32.2, C36.2, U2.8 (V+), U3.8 (V+), U4.2 (V+), U4.8 (EN); also elsewhere on the board
-VDAC: C17.2, C19.2, C21.2, C23.2, C33.2, C37.2, U2.4 (V-), U3.4 (V-), U4.4 (V-); also elsewhere on the board
/Output Stage/L+: C29.2, R19.2, R25.1, U3.7 (OUTB)
/Output Stage/L-: C28.1, R18.1, R21.2, U3.1 (OUTA)
/Output Stage/R+: C27.2, R17.2, R20.2, U2.7 (OUTB)
/Output Stage/R-: C26.1, R16.1, R22.2, U2.1 (OUTA)
/Output Stage/VBias_L: C25.2, R14.1, R15.2, U3.3 (+INA), U3.5 (+INB)
/Output Stage/VBias_R: C24.2, R12.1, R13.2, U2.3 (+INA), U2.5 (+INB)
AVCC_L: R14.2; also elsewhere on the board
AVCC_R: R12.2; also elsewhere on the board
DAC_OUTL_N: C28.2, R18.2, U3.2 (-INA); also elsewhere on the board
DAC_OUTL_P: C29.1, R19.1, U3.6 (-INB); also elsewhere on the board
DAC_OUTR_N: C26.2, R16.2, U2.2 (-INA); also elsewhere on the board
DAC_OUTR_P: C27.1, R17.1, U2.6 (-INB); also elsewhere on the board
GNDREF: C16.1, C17.1, C18.1, C19.1, C20.1, C21.1, C22.1, C23.1, C24.1, C25.1, C30.2, C31.1, C32.1, C33.1, C36.1, C37.1, R13.1, R15.1, R23.1, R24.2, U4.3 (GND), U4.11 (Thermal_pad); also elsewhere on the board
unnamed: C30.1, R20.1, R23.2, U4.1 (+INA)
unnamed: C31.2, R24.1, R25.2, U4.5 (+INB)
unnamed: C34.2, R22.1, R26.2, U4.10 (-INA)
unnamed: C35.1, R21.1, R27.1, U4.6 (-INB)
OUTL: C35.2, R27.2, U4.7 (OUTB); also elsewhere on the board
OUTR: C34.1, R26.1, U4.9 (OUTA); also elsewhere on the board

Notes on the sheet:
Transimpedance amplifier fc: 240kHz. 1/2piRC
Difference amplifier fc: 227kHz
Vbias = AVCC * (5k/(5k+4k)) = 3.3 * 0.5555 = 1.833V

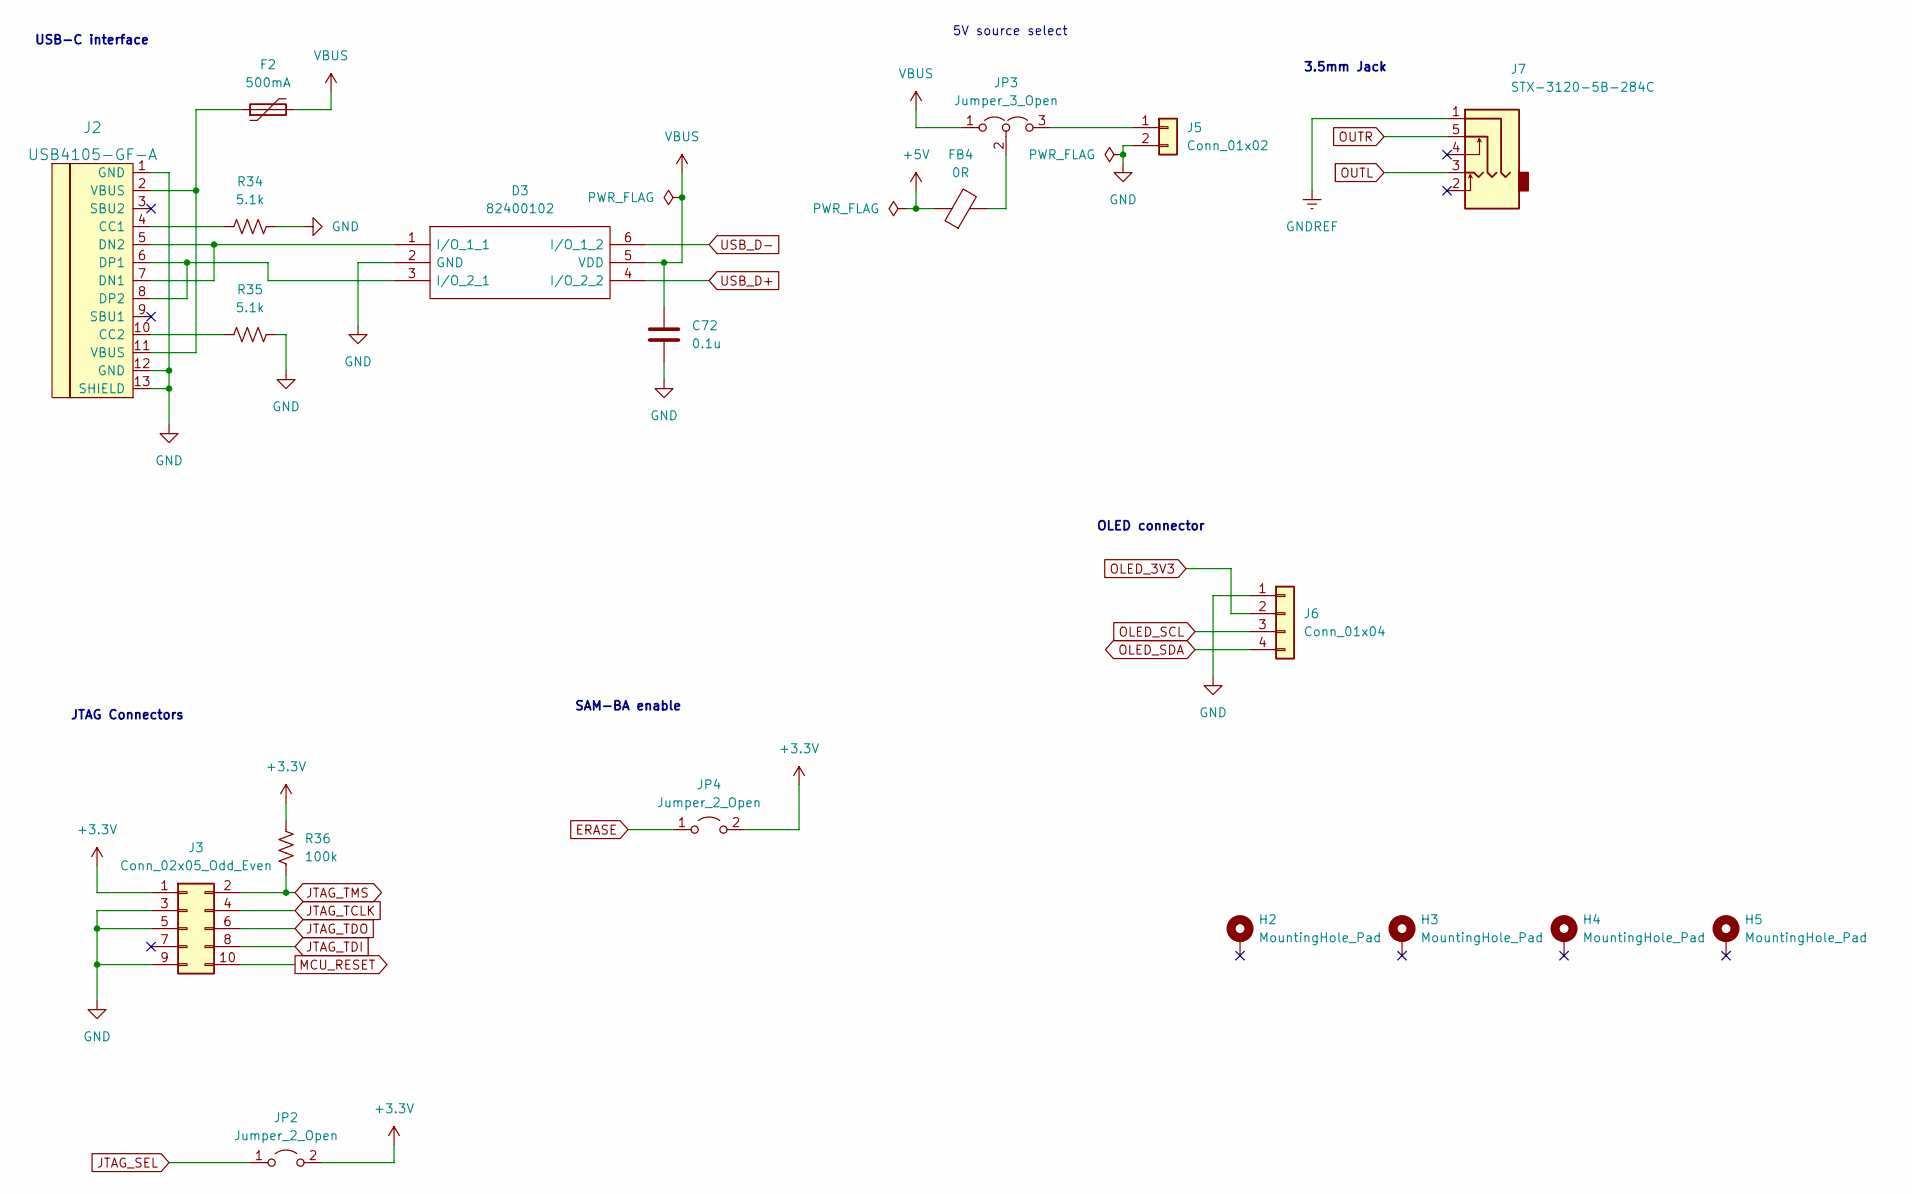
[picture p19: schematic connectors.kicad_sch]

Parts:
C72: 0.1u; C_0805_2012Metric_Pad1.18x1.45mm_HandSolder; Part Number CL21B104KBCNFNC; Mouser Part Number 187-CL21B104KBCNFNC
D3: 82400102; SOT95P280X145-6N; Manufacturer_Part_Number 82400102; Mouser Part Number 710-82400102
F2: 500mA; Fuse_1206_3216Metric; Part Number 1206L050/15YR; Mouser Part Number 576-1206L050/15YR
FB4: 0R; BEADC2012X110N; Part Number MFBW1V2012-000-R; Mouser Part Number 704-MFBW1V2012-000-R
H2, H3, H4, H5: MountingHole_Pad; MountingHole_2.2mm_M2_DIN965_Pad_TopBottom
J2: USB4105-GF-A; HRO-TYPE-C-31-M-12-HandSoldering; Part Number USB4105-GF-A; Mouser Part Number 640-USB4105-GF-A
J3: Conn_02x05_Odd_Even; PinHeader_2x05_P2.54mm_Vertical
J5: Conn_01x02; PinHeader_1x02_P2.54mm_Vertical
J6: Conn_01x04; PinHeader_1x04_P2.54mm_Vertical
J7: STX-3120-5B-284C; STX31205B284C; Part Number STX-3120-5B-284C; Mouser Part Number 806-STX-31205B284C
JP2, JP4: Jumper_2_Open; PinHeader_1x02_P2.54mm_Vertical
JP3: Jumper_3_Open; PinHeader_1x03_P2.54mm_Vertical
R34, R35: 5.1k; R_0805_2012Metric_Pad1.20x1.40mm_HandSolder; Part Number ERJ-6RBD5101V; Mouser Part Number 667-ERJ-6RBD5101V
R36: 100k; R_0805_2012Metric_Pad1.20x1.40mm_HandSolder; Part Number RCV0805100KJNEA; Mouser Part Number 71-RCV0805100KJNEA

Connections:
+3V3: J3.1, JP2.2 (B), JP4.2 (B), R36.2; also elsewhere on the board
ERASE: JP4.1 (A); also elsewhere on the board
GND: C72.2, D3.2 (GND), J2.1 (GND), J2.12 (GND), J2.13 (SHIELD), J3.3, J3.5, J3.9, J5.2, J6.1, R34.2, R35.2; also elsewhere on the board
GNDREF: J7.1; also elsewhere on the board
JTAG_SEL: JP2.1 (A); also elsewhere on the board
JTAG_TCLK: J3.4; also elsewhere on the board
JTAG_TDI: J3.8; also elsewhere on the board
JTAG_TDO: J3.6; also elsewhere on the board
JTAG_TMS: J3.2, R36.1; also elsewhere on the board
MCU_5V: FB4.1; also elsewhere on the board
MCU_RESET: J3.10; also elsewhere on the board
unnamed: D3.1 (I/O_1_1), J2.5 (DN2), J2.7 (DN1)
unnamed: D3.3 (I/O_2_1), J2.6 (DP1), J2.8 (DP2)
unnamed: F2.1, J2.2 (VBUS), J2.11 (VBUS)
unnamed: J2.4 (CC1), R34.1
unnamed: J2.10 (CC2), R35.1
unnamed: J5.1, JP3.3 (B)
unnamed: FB4.2, JP3.2 (C)
OLED_3V3: J6.2; also elsewhere on the board
OLED_SCL: J6.3; also elsewhere on the board
OLED_SDA: J6.4; also elsewhere on the board
OUTL: J7.3; also elsewhere on the board
OUTR: J7.5; also elsewhere on the board
USB_D+: D3.4 (I/O_2_2); also elsewhere on the board
USB_D-: D3.6 (I/O_1_2); also elsewhere on the board
VBUS: C72.1, D3.5 (VDD), F2.2, JP3.1 (A)

Notes on the sheet:
OLED connector
SAM-BA enable
JTAG Connectors
USB-C interface
5V source select
3.5mm Jack
