stefantquach/steDAC/KiCAD/steDAC.kicad_pcb

## KiCad design KiCAD/steDAC.kicad_pcb (continued)

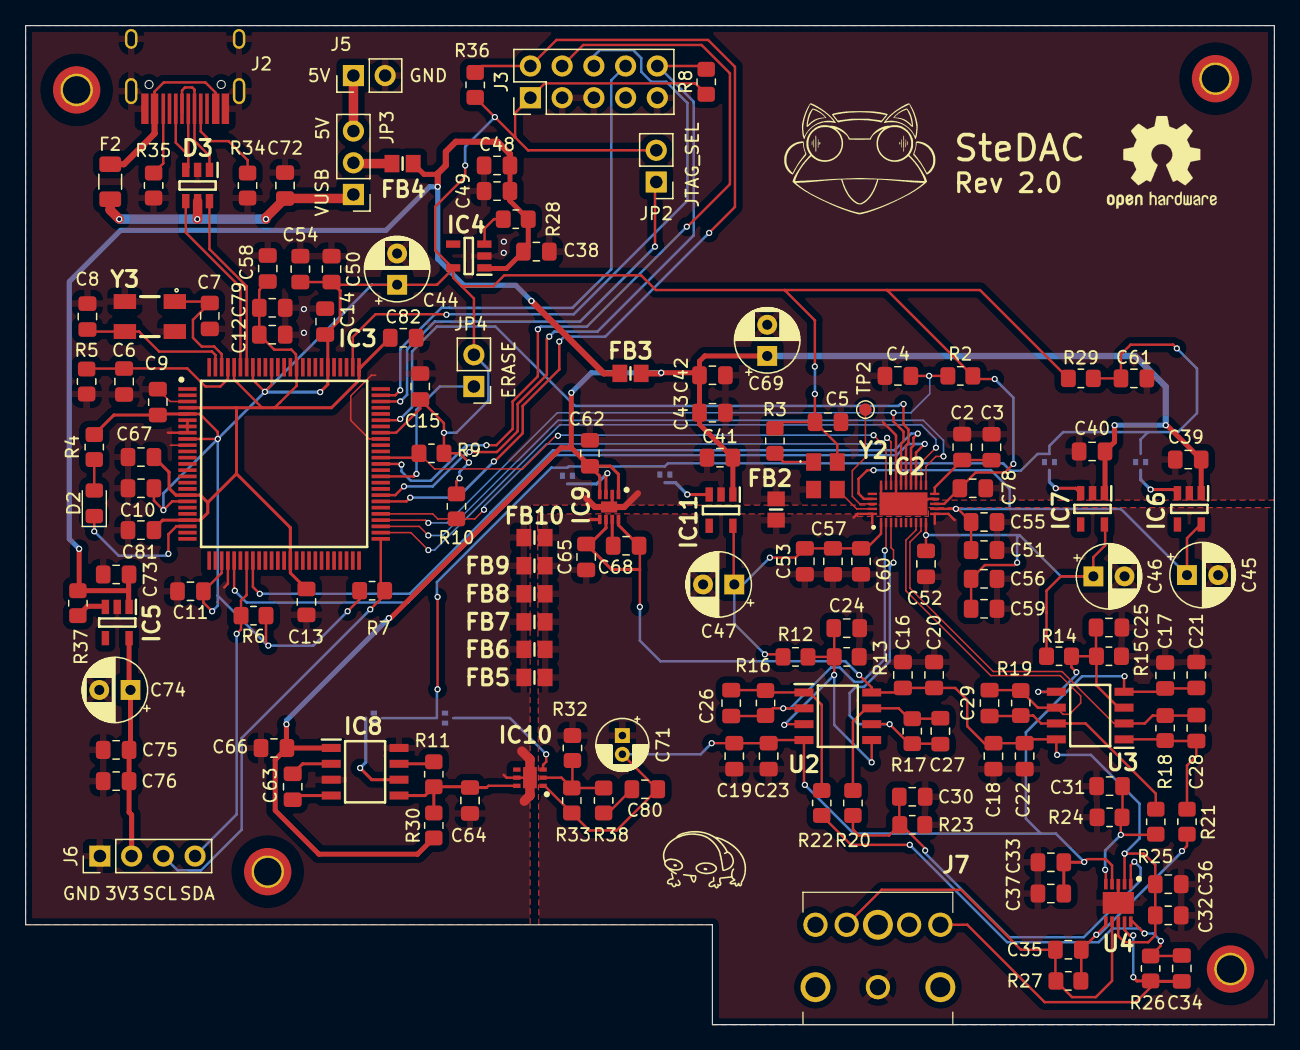
[picture p20: board steDAC.kicad_pcb from above]

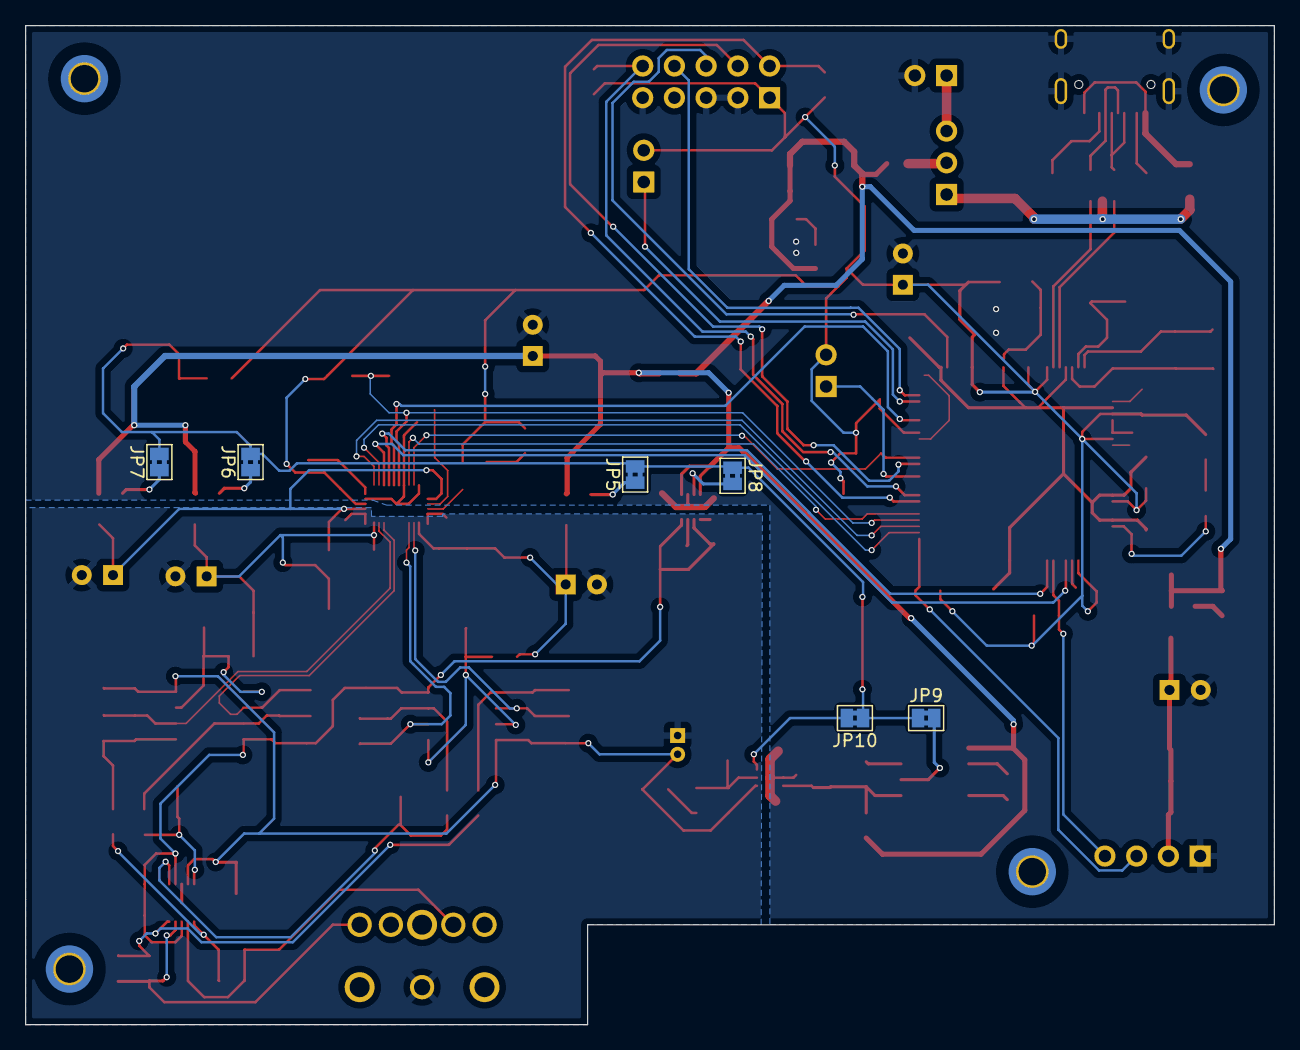
[picture p21: board steDAC.kicad_pcb from below]

Board: 2 copper layers, 100.0 x 80.0 mm, 161 parts (6 on the bottom side), 80 nets.
