stefantquach/steDAC/firmware/firmware/src/config/default/configuration.h

/*******************************************************************************
  System Configuration Header

  File Name:
    configuration.h

  Summary:
    Build-time configuration header for the system defined by this project.

  Description:
    An MPLAB Project may have multiple configurations.  This file defines the
    build-time options for a single configuration.

  Remarks:
    This configuration header must not define any prototypes or data
    definitions (or include any files that do).  It only provides macro
    definitions for build-time configuration options

*******************************************************************************/

// DOM-IGNORE-BEGIN
/*******************************************************************************
* Copyright (C) 2018 Microchip Technology Inc. and its subsidiaries.
*
* Subject to your compliance with these terms, you may use Microchip software
* and any derivatives exclusively with Microchip products. It is your
* responsibility to comply with third party license terms applicable to your
* use of third party software (including open source software) that may
* accompany Microchip software.
*
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
* IN NO EVENT WILL MICROCHIP BE LIABLE FOR ANY INDIRECT, SPECIAL, PUNITIVE,
* INCIDENTAL OR CONSEQUENTIAL LOSS, DAMAGE, COST OR EXPENSE OF ANY KIND
* WHATSOEVER RELATED TO THE SOFTWARE, HOWEVER CAUSED, EVEN IF MICROCHIP HAS
* BEEN ADVISED OF THE POSSIBILITY OR THE DAMAGES ARE FORESEEABLE. TO THE
* FULLEST EXTENT ALLOWED BY LAW, MICROCHIP'S TOTAL LIABILITY ON ALL CLAIMS IN
* ANY WAY RELATED TO THIS SOFTWARE WILL NOT EXCEED THE AMOUNT OF FEES, IF ANY,
* THAT YOU HAVE PAID DIRECTLY TO MICROCHIP FOR THIS SOFTWARE.
*******************************************************************************/
// DOM-IGNORE-END

#ifndef CONFIGURATION_H
#define CONFIGURATION_H

// *****************************************************************************
// *****************************************************************************
// Section: Included Files
// *****************************************************************************
// *****************************************************************************
/*  This section Includes other configuration headers necessary to completely
    define this configuration.
*/

#include "user.h"
#include "device.h"

// DOM-IGNORE-BEGIN
#ifdef __cplusplus  // Provide C++ Compatibility

extern "C" {

#endif
// DOM-IGNORE-END

// *****************************************************************************
// *****************************************************************************
// Section: System Configuration
// *****************************************************************************
// *****************************************************************************



// *****************************************************************************
// *****************************************************************************
// Section: System Service Configuration
// *****************************************************************************
// *****************************************************************************


// *****************************************************************************
// *****************************************************************************
// Section: Driver Configuration
// *****************************************************************************
// *****************************************************************************
/* I2S Driver Instance 0 Configuration Options */
#define DRV_I2S_INDEX_0                0
#define DRV_I2S_CLIENTS_NUMBER_IDX0    1
#define DRV_I2S_QUEUE_DEPTH_COMBINED                 (2*8)
#define DRV_I2S_QUEUE_SIZE_IDX0        8
#define DRV_I2S_DATA_LENGTH_IDX0       16
#define DRV_I2S_INT_SRC_IDX0           I2SC0_IRQn
#define DRV_I2S_XMIT_DMA_CH_IDX0       SYS_DMA_CHANNEL_0
#define DRV_I2S_RCV_DMA_CH_IDX0        SYS_DMA_CHANNEL_1

/* I2S Driver Common Configuration Options */
#define DRV_I2S_INSTANCES_NUMBER              1



// *****************************************************************************
// *****************************************************************************
// Section: Middleware & Other Library Configuration
// *****************************************************************************
// *****************************************************************************
/* Number of Endpoints used */
#define DRV_USBHSV1_ENDPOINTS_NUMBER                        6

/* The USB Device Layer will not initialize the USB Driver */
#define USB_DEVICE_DRIVER_INITIALIZE_EXPLICIT

/* Maximum device layer instances */
#define USB_DEVICE_INSTANCES_NUMBER                         1

/* EP0 size in bytes */
#define USB_DEVICE_EP0_BUFFER_SIZE                          64



/* Maximum instances of CDC function driver */
#define USB_DEVICE_CDC_INSTANCES_NUMBER                     1


/* CDC Transfer Queue Size for both read and
   write. Applicable to all instances of the
   function driver */
#define USB_DEVICE_CDC_QUEUE_DEPTH_COMBINED                 3

/*** USB Driver Configuration ***/

/* Maximum USB driver instances */
#define DRV_USBHSV1_INSTANCES_NUMBER                        1

/* Interrupt mode enabled */
#define DRV_USBHSV1_INTERRUPT_MODE                          true

/* Enables Device Support */
#define DRV_USBHSV1_DEVICE_SUPPORT                          true
	
/* Disable Host Support */
#define DRV_USBHSV1_HOST_SUPPORT                            false

/* Alignment for buffers that are submitted to USB Driver*/ 
#define USB_ALIGN  CACHE_ALIGN

/* Maximum instances of Audio function driver */
#define USB_DEVICE_AUDIO_V2_INSTANCES_NUMBER    1 


/* Audio Transfer Queue Size for both read and
   write. Applicable to all instances of the
   function driver */
#define  USB_DEVICE_AUDIO_V2_QUEUE_DEPTH_COMBINED 2

/* No of Audio streaming interfaces */
#define USB_DEVICE_AUDIO_V2_MAX_STREAMING_INTERFACES   1

/* No of alternate settings */
#define USB_DEVICE_AUDIO_V2_MAX_ALTERNATE_SETTING      2




// *****************************************************************************
// *****************************************************************************
// Section: Application Configuration
// *****************************************************************************
// *****************************************************************************


//DOM-IGNORE-BEGIN
#ifdef __cplusplus
}
#endif
//DOM-IGNORE-END

#endif // CONFIGURATION_H
/*******************************************************************************
 End of File
*/
