stefantquach/steDAC/firmware/firmware/src/config/default/default.mhc/project.yml

files:
- generatedChecksum: F58DB2348A0FCE945652B285010E5F8A
  logicalPath: FreeRTOS/Source
  name: FreeRTOS_tasks.c
  physicalPath: ../../third_party/rtos/FreeRTOS/Source
  security: NON_SECURE
  type: SOURCE
  userChecksum: F58DB2348A0FCE945652B285010E5F8A
- generatedChecksum: null
  logicalPath: ''
  name: app.cpp
  physicalPath: ../..
  security: NON_SECURE
  type: SOURCE
  userChecksum: null
- generatedChecksum: 8ACE0DEBD82F6829438A4674565451FB
  logicalPath: FreeRTOS/Source
  name: croutine.c
  physicalPath: ../../third_party/rtos/FreeRTOS/Source
  security: NON_SECURE
  type: SOURCE
  userChecksum: 8ACE0DEBD82F6829438A4674565451FB
- generatedChecksum: 4A216E0A2F558F545F5F15E5A2DC47B1
  logicalPath: config/default/audio/driver/i2s
  name: drv_i2s.c
  physicalPath: audio/driver/i2s/src
  security: NON_SECURE
  type: SOURCE
  userChecksum: E178AE22B4DFD4836424C10E5920C63F
- generatedChecksum: 680300EC1B71F449C4265A35B9ECA1BF
  logicalPath: config/default/driver/usb/usbhsv1/src
  name: drv_usbhsv1.c
  physicalPath: driver/usb/usbhsv1/src
  security: NON_SECURE
  type: SOURCE
  userChecksum: 680300EC1B71F449C4265A35B9ECA1BF
- generatedChecksum: 33A4AF962D182E0E51963CD431EE5B25
  logicalPath: config/default/driver/usb/usbhsv1/src
  name: drv_usbhsv1_device.c
  physicalPath: driver/usb/usbhsv1/src
  security: NON_SECURE
  type: SOURCE
  userChecksum: 33A4AF962D182E0E51963CD431EE5B25
- generatedChecksum: B3B5445B14BD9B6A35F1C5B995C9BBF7
  logicalPath: FreeRTOS/Source
  name: event_groups.c
  physicalPath: ../../third_party/rtos/FreeRTOS/Source
  security: NON_SECURE
  type: SOURCE
  userChecksum: B3B5445B14BD9B6A35F1C5B995C9BBF7
- generatedChecksum: 6069C4FD56993BDA3B1FC223DD5BAA4A
  logicalPath: config/default
  name: exceptions.c
  physicalPath: ''
  security: NON_SECURE
  type: SOURCE
  userChecksum: 6069C4FD56993BDA3B1FC223DD5BAA4A
- generatedChecksum: B7DBFD6F500AAD4713403E985EB18EAE
  logicalPath: config/default
  name: freertos_hooks.c
  physicalPath: ''
  security: NON_SECURE
  type: SOURCE
  userChecksum: B7DBFD6F500AAD4713403E985EB18EAE
- generatedChecksum: 972E955D94A63BA89BF6ABD6AADB1023
  logicalPath: FreeRTOS/Source/portable/MemMang
  name: heap_1.c
  physicalPath: ../../third_party/rtos/FreeRTOS/Source/portable/MemMang
  security: NON_SECURE
  type: SOURCE
  userChecksum: 972E955D94A63BA89BF6ABD6AADB1023
- generatedChecksum: B5454C0A45522963B6938E78134F0505
  logicalPath: config/default
  name: initialization.c
  physicalPath: ''
  security: NON_SECURE
  type: SOURCE
  userChecksum: B5454C0A45522963B6938E78134F0505
- generatedChecksum: 8D1F5E92E2DBB8BFDDF87B5A6E079BC1
  logicalPath: config/default
  name: interrupts.c
  physicalPath: ''
  security: NON_SECURE
  type: SOURCE
  userChecksum: 8D1F5E92E2DBB8BFDDF87B5A6E079BC1
- generatedChecksum: 6513F2461B8F476B68CA73906086047F
  logicalPath: config/default
  name: libc_syscalls.c
  physicalPath: ''
  security: NON_SECURE
  type: SOURCE
  userChecksum: 6513F2461B8F476B68CA73906086047F
- generatedChecksum: 3FEE521CEF14928AE38E7FA9BF6D75E6
  logicalPath: FreeRTOS/Source
  name: list.c
  physicalPath: ../../third_party/rtos/FreeRTOS/Source
  security: NON_SECURE
  type: SOURCE
  userChecksum: 3FEE521CEF14928AE38E7FA9BF6D75E6
- generatedChecksum: null
  logicalPath: ''
  name: main.cpp
  physicalPath: ../..
  security: NON_SECURE
  type: SOURCE
  userChecksum: null
- generatedChecksum: 8FDD6248506F28B32C4F5FD9AA0D9C6F
  logicalPath: config/default/osal
  name: osal_freertos.c
  physicalPath: osal
  security: NON_SECURE
  type: SOURCE
  userChecksum: 8FDD6248506F28B32C4F5FD9AA0D9C6F
- generatedChecksum: FCD2F0C30F511E4DE22D8D8B467FF30F
  logicalPath: config/default/peripheral/clk
  name: plib_clk.c
  physicalPath: peripheral/clk
  security: NON_SECURE
  type: SOURCE
  userChecksum: FCD2F0C30F511E4DE22D8D8B467FF30F
- generatedChecksum: D23DF612DB8267EDD9F5F3A463A02DB2
  logicalPath: config/default/peripheral/efc
  name: plib_efc.c
  physicalPath: peripheral/efc
  security: NON_SECURE
  type: SOURCE
  userChecksum: D23DF612DB8267EDD9F5F3A463A02DB2
- generatedChecksum: 5400C56CFB0FC44199A6D7D97334870E
  logicalPath: config/default/audio/peripheral/i2sc
  name: plib_i2sc0.c
  physicalPath: audio/peripheral/i2sc
  security: NON_SECURE
  type: SOURCE
  userChecksum: 5400C56CFB0FC44199A6D7D97334870E
- generatedChecksum: 256BAAD14728C59CCFEDAA0CEDD460CD
  logicalPath: config/default/peripheral/nvic
  name: plib_nvic.c
  physicalPath: peripheral/nvic
  security: NON_SECURE
  type: SOURCE
  userChecksum: 256BAAD14728C59CCFEDAA0CEDD460CD
- generatedChecksum: 037D56F5F7B1062C94C58311A778D8D4
  logicalPath: config/default/peripheral/pio
  name: plib_pio.c
  physicalPath: peripheral/pio
  security: NON_SECURE
  type: SOURCE
  userChecksum: 037D56F5F7B1062C94C58311A778D8D4
- generatedChecksum: 2986B2EF8294381D1A3750220DB411CA
  logicalPath: config/default/peripheral/tc
  name: plib_tc0.c
  physicalPath: peripheral/tc
  security: NON_SECURE
  type: SOURCE
  userChecksum: 2986B2EF8294381D1A3750220DB411CA
- generatedChecksum: 618A850993F2C71CF51F61BBED137616
  logicalPath: config/default/peripheral/twihs/master
  name: plib_twihs0_master.c
  physicalPath: peripheral/twihs/master
  security: NON_SECURE
  type: SOURCE
  userChecksum: 618A850993F2C71CF51F61BBED137616
- generatedChecksum: 24304E3E8C225A7ECA10903D555248F8
  logicalPath: config/default/peripheral/twihs/master
  name: plib_twihs2_master.c
  physicalPath: peripheral/twihs/master
  security: NON_SECURE
  type: SOURCE
  userChecksum: 24304E3E8C225A7ECA10903D555248F8
- generatedChecksum: 8B0128F913B7BA6526F8AA717572E71D
  logicalPath: config/default/peripheral/xdmac
  name: plib_xdmac.c
  physicalPath: peripheral/xdmac
  security: NON_SECURE
  type: SOURCE
  userChecksum: 8B0128F913B7BA6526F8AA717572E71D
- generatedChecksum: A44EAFDF7F180C2C05A0AE0AEB3FB80C
  logicalPath: FreeRTOS/Source/portable/GCC/SAM/CM7
  name: port.c
  physicalPath: ../../third_party/rtos/FreeRTOS/Source/portable/GCC/SAM/CM7
  security: NON_SECURE
  type: SOURCE
  userChecksum: A44EAFDF7F180C2C05A0AE0AEB3FB80C
- generatedChecksum: 09041728D74A4E3A32C7D4EAA96C4EE7
  logicalPath: FreeRTOS/Source
  name: queue.c
  physicalPath: ../../third_party/rtos/FreeRTOS/Source
  security: NON_SECURE
  type: SOURCE
  userChecksum: 09041728D74A4E3A32C7D4EAA96C4EE7
- generatedChecksum: 3A35F794BD3C19E7B3142ED6806E4EFE
  logicalPath: config/default
  name: startup_xc32.c
  physicalPath: ''
  security: NON_SECURE
  type: SOURCE
  userChecksum: 3A35F794BD3C19E7B3142ED6806E4EFE
- generatedChecksum: D6CF30BDCE1A813D9ACF3905EBD6A871
  logicalPath: FreeRTOS/Source
  name: stream_buffer.c
  physicalPath: ../../third_party/rtos/FreeRTOS/Source
  security: NON_SECURE
  type: SOURCE
  userChecksum: D6CF30BDCE1A813D9ACF3905EBD6A871
- generatedChecksum: 9063CE23C03357B7F90CA6887D4BCAF9
  logicalPath: config/default/system/cache
  name: sys_cache.c
  physicalPath: system/cache
  security: NON_SECURE
  type: SOURCE
  userChecksum: 9063CE23C03357B7F90CA6887D4BCAF9
- generatedChecksum: C36B60946A5F6A83472CF2BA69FCEFB4
  logicalPath: config/default/system/dma
  name: sys_dma.c
  physicalPath: system/dma
  security: NON_SECURE
  type: SOURCE
  userChecksum: C36B60946A5F6A83472CF2BA69FCEFB4
- generatedChecksum: 02C3C1B519E59992810626BB6098CF56
  logicalPath: config/default/system/int
  name: sys_int.c
  physicalPath: system/int/src
  security: NON_SECURE
  type: SOURCE
  userChecksum: 02C3C1B519E59992810626BB6098CF56
- generatedChecksum: C0B55E4D4726999758344B4532A6EF5F
  logicalPath: config/default
  name: tasks.c
  physicalPath: ''
  security: NON_SECURE
  type: SOURCE
  userChecksum: C0B55E4D4726999758344B4532A6EF5F
- generatedChecksum: F1B86F6E1527FD59A8713B67564F2898
  logicalPath: FreeRTOS/Source
  name: timers.c
  physicalPath: ../../third_party/rtos/FreeRTOS/Source
  security: NON_SECURE
  type: SOURCE
  userChecksum: F1B86F6E1527FD59A8713B67564F2898
- generatedChecksum: BCCEF5B801FFD0CF22D0B454D2F25F1F
  logicalPath: config/default/usb/src
  name: usb_device.c
  physicalPath: usb/src
  security: NON_SECURE
  type: SOURCE
  userChecksum: BCCEF5B801FFD0CF22D0B454D2F25F1F
- generatedChecksum: 7C528BE742BB262966BBA8724820C38D
  logicalPath: config/default/usb/src
  name: usb_device_audio_v2_0.c
  physicalPath: usb/src
  security: NON_SECURE
  type: SOURCE
  userChecksum: 7C528BE742BB262966BBA8724820C38D
- generatedChecksum: FEE7D0E45836A89D2B9D58010D88F6DD
  logicalPath: config/default/usb/src
  name: usb_device_audio_v2_read_write.c
  physicalPath: usb/src
  security: NON_SECURE
  type: SOURCE
  userChecksum: FEE7D0E45836A89D2B9D58010D88F6DD
- generatedChecksum: A40DCA3705B81ABAAC49D5107947C230
  logicalPath: config/default/usb/src
  name: usb_device_cdc.c
  physicalPath: usb/src
  security: NON_SECURE
  type: SOURCE
  userChecksum: A40DCA3705B81ABAAC49D5107947C230
- generatedChecksum: ABA41F10EA872DBEBB285D03A009BC51
  logicalPath: config/default/usb/src
  name: usb_device_cdc_acm.c
  physicalPath: usb/src
  security: NON_SECURE
  type: SOURCE
  userChecksum: ABA41F10EA872DBEBB285D03A009BC51
- generatedChecksum: 42F44B86A20C5F0B660A758048BC8329
  logicalPath: config/default
  name: usb_device_init_data.c
  physicalPath: ''
  security: NON_SECURE
  type: SOURCE
  userChecksum: 42F44B86A20C5F0B660A758048BC8329
- generatedChecksum: 7806B30ECAE0D18D08CD583D8775530D
  logicalPath: config/default/stdio
  name: xc32_monitor.c
  physicalPath: stdio
  security: NON_SECURE
  type: SOURCE
  userChecksum: 7806B30ECAE0D18D08CD583D8775530D
- generatedChecksum: AF3A8D8AA610E7DFD3E38DDAC5E42074
  logicalPath: FreeRTOS/Source/include
  name: FreeRTOS.h
  physicalPath: ../../third_party/rtos/FreeRTOS/Source/include
  security: NON_SECURE
  type: HEADER
  userChecksum: AF3A8D8AA610E7DFD3E38DDAC5E42074
- generatedChecksum: 85814EC29A5445EBC540EAE6D59ECBDA
  logicalPath: config/default
  name: FreeRTOSConfig.h
  physicalPath: ''
  security: NON_SECURE
  type: HEADER
  userChecksum: 85814EC29A5445EBC540EAE6D59ECBDA
- generatedChecksum: 06421D7A9FFB5AF65A948E0B70CD8723
  logicalPath: packs/ATSAMS70N19B_DFP/component
  name: acc.h
  physicalPath: ../../packs/ATSAMS70N19B_DFP/component
  security: NON_SECURE
  type: HEADER
  userChecksum: 06421D7A9FFB5AF65A948E0B70CD8723
- generatedChecksum: A9494F0F9512ECD4534C48480FA9D31B
  logicalPath: packs/ATSAMS70N19B_DFP/instance
  name: acc.h
  physicalPath: ../../packs/ATSAMS70N19B_DFP/instance
  security: NON_SECURE
  type: HEADER
  userChecksum: A9494F0F9512ECD4534C48480FA9D31B
- generatedChecksum: 3A5EBA0861FBD7B380D6CD59B23ECAD8
  logicalPath: packs/ATSAMS70N19B_DFP/component
  name: aes.h
  physicalPath: ../../packs/ATSAMS70N19B_DFP/component
  security: NON_SECURE
  type: HEADER
  userChecksum: 3A5EBA0861FBD7B380D6CD59B23ECAD8
- generatedChecksum: A5F434E9661CC0507F03CE48A9BE1CA9
  logicalPath: packs/ATSAMS70N19B_DFP/instance
  name: aes.h
  physicalPath: ../../packs/ATSAMS70N19B_DFP/instance
  security: NON_SECURE
  type: HEADER
  userChecksum: A5F434E9661CC0507F03CE48A9BE1CA9
- generatedChecksum: B859A686B67F470F1ED7333D7751B651
  logicalPath: packs/ATSAMS70N19B_DFP/component
  name: afec.h
  physicalPath: ../../packs/ATSAMS70N19B_DFP/component
  security: NON_SECURE
  type: HEADER
  userChecksum: B859A686B67F470F1ED7333D7751B651
- generatedChecksum: 90C28FD693D63CBF8ACB969AA895CBB2
  logicalPath: packs/ATSAMS70N19B_DFP/instance
  name: afec0.h
  physicalPath: ../../packs/ATSAMS70N19B_DFP/instance
  security: NON_SECURE
  type: HEADER
  userChecksum: 90C28FD693D63CBF8ACB969AA895CBB2
- generatedChecksum: 10896427C673E48D41E73E13CDACBF28
  logicalPath: packs/ATSAMS70N19B_DFP/instance
  name: afec1.h
  physicalPath: ../../packs/ATSAMS70N19B_DFP/instance
  security: NON_SECURE
  type: HEADER
  userChecksum: 10896427C673E48D41E73E13CDACBF28
- generatedChecksum: null
  logicalPath: ''
  name: app.h
  physicalPath: ../..
  security: NON_SECURE
  type: HEADER
  userChecksum: null
- generatedChecksum: 14F1AD56D242EFD0AF76849C6ADFECC4
  logicalPath: packs/CMSIS/CMSIS/Core/Include
  name: cachel1_armv7.h
  physicalPath: ../../packs/CMSIS/CMSIS/Core/Include
  security: NON_SECURE
  type: HEADER
  userChecksum: 14F1AD56D242EFD0AF76849C6ADFECC4
- generatedChecksum: 577349A48E6CA8A2E81F44AB382AE6A7
  logicalPath: packs/ATSAMS70N19B_DFP/component
  name: chipid.h
  physicalPath: ../../packs/ATSAMS70N19B_DFP/component
  security: NON_SECURE
  type: HEADER
  userChecksum: 577349A48E6CA8A2E81F44AB382AE6A7
- generatedChecksum: AF6065F188F6D467D05E127189EFB0ED
  logicalPath: packs/ATSAMS70N19B_DFP/instance
  name: chipid.h
  physicalPath: ../../packs/ATSAMS70N19B_DFP/instance
  security: NON_SECURE
  type: HEADER
  userChecksum: AF6065F188F6D467D05E127189EFB0ED
- generatedChecksum: B79C08E0901948AD04D944B4BCE1B60D
  logicalPath: packs/CMSIS/CMSIS/Core/Include
  name: cmsis_armcc.h
  physicalPath: ../../packs/CMSIS/CMSIS/Core/Include
  security: NON_SECURE
  type: HEADER
  userChecksum: B79C08E0901948AD04D944B4BCE1B60D
- generatedChecksum: 6B4E2EBA8708D9E04E6136F29460ACB9
  logicalPath: packs/CMSIS/CMSIS/Core/Include
  name: cmsis_armclang.h
  physicalPath: ../../packs/CMSIS/CMSIS/Core/Include
  security: NON_SECURE
  type: HEADER
  userChecksum: 6B4E2EBA8708D9E04E6136F29460ACB9
- generatedChecksum: 415E22EBE7A3BACE87240A7F16492C46
  logicalPath: packs/CMSIS/CMSIS/Core/Include
  name: cmsis_armclang_ltm.h
  physicalPath: ../../packs/CMSIS/CMSIS/Core/Include
  security: NON_SECURE
  type: HEADER
  userChecksum: 415E22EBE7A3BACE87240A7F16492C46
- generatedChecksum: 60385A5C6C9882B5D30709A1F6EAEC35
  logicalPath: packs/CMSIS/CMSIS/Core/Include
  name: cmsis_compiler.h
  physicalPath: ../../packs/CMSIS/CMSIS/Core/Include
  security: NON_SECURE
  type: HEADER
  userChecksum: 60385A5C6C9882B5D30709A1F6EAEC35
- generatedChecksum: 4DC978B079559EB044AFD32A57768238
  logicalPath: packs/CMSIS/CMSIS/Core/Include
  name: cmsis_gcc.h
  physicalPath: ../../packs/CMSIS/CMSIS/Core/Include
  security: NON_SECURE
  type: HEADER
  userChecksum: 4DC978B079559EB044AFD32A57768238
- generatedChecksum: 11521476050CAC6C1F3A91A5BB5DBB9A
  logicalPath: packs/CMSIS/CMSIS/Core/Include
  name: cmsis_iccarm.h
  physicalPath: ../../packs/CMSIS/CMSIS/Core/Include
  security: NON_SECURE
  type: HEADER
  userChecksum: 11521476050CAC6C1F3A91A5BB5DBB9A
- generatedChecksum: 52F91AC0727F2311EDA0E3BAA7719A9F
  logicalPath: packs/CMSIS/CMSIS/Core/Include
  name: cmsis_version.h
  physicalPath: ../../packs/CMSIS/CMSIS/Core/Include
  security: NON_SECURE
  type: HEADER
  userChecksum: 52F91AC0727F2311EDA0E3BAA7719A9F
- generatedChecksum: 4D86D083393D49153F918E4B86A28703
  logicalPath: config/default
  name: configuration.h
  physicalPath: ''
  security: NON_SECURE
  type: HEADER
  userChecksum: 4D86D083393D49153F918E4B86A28703
- generatedChecksum: 948CEA542F04017255B040816F368DF8
  logicalPath: packs/CMSIS/CMSIS/Core/Include
  name: core_cm7.h
  physicalPath: ../../packs/CMSIS/CMSIS/Core/Include
  security: NON_SECURE
  type: HEADER
  userChecksum: 948CEA542F04017255B040816F368DF8
- generatedChecksum: 48B661D8C967C6BC397001F10FB43D1D
  logicalPath: FreeRTOS/Source/include
  name: croutine.h
  physicalPath: ../../third_party/rtos/FreeRTOS/Source/include
  security: NON_SECURE
  type: HEADER
  userChecksum: 48B661D8C967C6BC397001F10FB43D1D
- generatedChecksum: 7D1B8FA3875AC329A8F752A33BEF4F90
  logicalPath: packs/ATSAMS70N19B_DFP/component
  name: dacc.h
  physicalPath: ../../packs/ATSAMS70N19B_DFP/component
  security: NON_SECURE
  type: HEADER
  userChecksum: 7D1B8FA3875AC329A8F752A33BEF4F90
- generatedChecksum: 5E1EF76DC00E7B8AA5A294EEA18EC64D
  logicalPath: packs/ATSAMS70N19B_DFP/instance
  name: dacc.h
  physicalPath: ../../packs/ATSAMS70N19B_DFP/instance
  security: NON_SECURE
  type: HEADER
  userChecksum: 5E1EF76DC00E7B8AA5A294EEA18EC64D
- generatedChecksum: 90A6B5D0972A65072293469D2AC332EE
  logicalPath: config/default
  name: definitions.h
  physicalPath: ''
  security: NON_SECURE
  type: HEADER
  userChecksum: 90A6B5D0972A65072293469D2AC332EE
- generatedChecksum: 1EA4EDD5EA90F43EC407DE32441159A9
  logicalPath: FreeRTOS/Source/include
  name: deprecated_definitions.h
  physicalPath: ../../third_party/rtos/FreeRTOS/Source/include
  security: NON_SECURE
  type: HEADER
  userChecksum: 1EA4EDD5EA90F43EC407DE32441159A9
- generatedChecksum: 1969AB153ADFA1D9281484E246610F10
  logicalPath: config/default
  name: device.h
  physicalPath: ''
  security: NON_SECURE
  type: HEADER
  userChecksum: 1969AB153ADFA1D9281484E246610F10
- generatedChecksum: 9FD18F0D30B89945CC141BA0DE2ABE90
  logicalPath: config/default
  name: device_cache.h
  physicalPath: ''
  security: NON_SECURE
  type: HEADER
  userChecksum: 9FD18F0D30B89945CC141BA0DE2ABE90
- generatedChecksum: EBD41C9494DB601338B4F2DDFC0BEC64
  logicalPath: config/default
  name: device_vectors.h
  physicalPath: ''
  security: NON_SECURE
  type: HEADER
  userChecksum: EBD41C9494DB601338B4F2DDFC0BEC64
- generatedChecksum: 1D2094DFA60F847FFD4E8153B6E78027
  logicalPath: config/default/driver
  name: driver.h
  physicalPath: driver
  security: NON_SECURE
  type: HEADER
  userChecksum: 1D2094DFA60F847FFD4E8153B6E78027
- generatedChecksum: CC7DFCC51CD25171A3E400E18969354F
  logicalPath: config/default/driver
  name: driver_common.h
  physicalPath: driver
  security: NON_SECURE
  type: HEADER
  userChecksum: CC7DFCC51CD25171A3E400E18969354F
- generatedChecksum: BBD8905E10243A030CAFF6CA8AC8E708
  logicalPath: config/default/audio/driver/i2s
  name: drv_i2s.h
  physicalPath: audio/driver/i2s
  security: NON_SECURE
  type: HEADER
  userChecksum: BBD8905E10243A030CAFF6CA8AC8E708
- generatedChecksum: F5A52627FD41F42187E27EC7CA7E0DC4
  logicalPath: config/default/audio/driver/i2s
  name: drv_i2s_definitions.h
  physicalPath: audio/driver/i2s
  security: NON_SECURE
  type: HEADER
  userChecksum: F5A52627FD41F42187E27EC7CA7E0DC4
- generatedChecksum: EC8C2E0CE26788EAC03D8A83CEB7FA80
  logicalPath: config/default/audio/driver/i2s
  name: drv_i2s_local.h
  physicalPath: audio/driver/i2s
  security: NON_SECURE
  type: HEADER
  userChecksum: EC8C2E0CE26788EAC03D8A83CEB7FA80
- generatedChecksum: DF147276AE56CA76E3E9BEB8447620AB
  logicalPath: config/default/driver/usb
  name: drv_usb.h
  physicalPath: driver/usb
  security: NON_SECURE
  type: HEADER
  userChecksum: DF147276AE56CA76E3E9BEB8447620AB
- generatedChecksum: A8072403A5346EF85CDFD4EF996C0826
  logicalPath: config/default/driver/usb
  name: drv_usb_external_dependencies.h
  physicalPath: driver/usb
  security: NON_SECURE
  type: HEADER
  userChecksum: A8072403A5346EF85CDFD4EF996C0826
- generatedChecksum: 6F8CC07CA11B3FD9B105D2AFE9FE3A28
  logicalPath: config/default/driver/usb/usbhsv1
  name: drv_usbhsv1.h
  physicalPath: driver/usb/usbhsv1
  security: NON_SECURE
  type: HEADER
  userChecksum: 6F8CC07CA11B3FD9B105D2AFE9FE3A28
- generatedChecksum: 2CDE0E6FF0A0FF3E14F743D08E064584
  logicalPath: config/default/driver/usb/usbhsv1/src
  name: drv_usbhsv1_local.h
  physicalPath: driver/usb/usbhsv1/src
  security: NON_SECURE
  type: HEADER
  userChecksum: 2CDE0E6FF0A0FF3E14F743D08E064584
- generatedChecksum: F4E8736C8A43D37DDC0F661D194AAF8A
  logicalPath: config/default/driver/usb/usbhsv1/src
  name: drv_usbhsv1_variant_mapping.h
  physicalPath: driver/usb/usbhsv1/src
  security: NON_SECURE
  type: HEADER
  userChecksum: F4E8736C8A43D37DDC0F661D194AAF8A
- generatedChecksum: 46AC709FAF25780132BA802DA2964A17
  logicalPath: packs/ATSAMS70N19B_DFP/component
  name: efc.h
  physicalPath: ../../packs/ATSAMS70N19B_DFP/component
  security: NON_SECURE
  type: HEADER
  userChecksum: 46AC709FAF25780132BA802DA2964A17
- generatedChecksum: 58A1EE1A27C7F2211672475D032570C1
  logicalPath: packs/ATSAMS70N19B_DFP/instance
  name: efc.h
  physicalPath: ../../packs/ATSAMS70N19B_DFP/instance
  security: NON_SECURE
  type: HEADER
  userChecksum: 58A1EE1A27C7F2211672475D032570C1
- generatedChecksum: B1D1D455E111FA70C46AD40562D78CE2
  logicalPath: FreeRTOS/Source/include
  name: event_groups.h
  physicalPath: ../../third_party/rtos/FreeRTOS/Source/include
  security: NON_SECURE
  type: HEADER
  userChecksum: B1D1D455E111FA70C46AD40562D78CE2
- generatedChecksum: FB7AC6F47CFA692FF1D3C97101DD7312
  logicalPath: packs/ATSAMS70N19B_DFP/component
  name: fuses.h
  physicalPath: ../../packs/ATSAMS70N19B_DFP/component
  security: NON_SECURE
  type: HEADER
  userChecksum: FB7AC6F47CFA692FF1D3C97101DD7312
- generatedChecksum: 3DB103D2D5A500E0DAB6A4CA0EE9C25B
  logicalPath: packs/ATSAMS70N19B_DFP/instance
  name: fuses.h
  physicalPath: ../../packs/ATSAMS70N19B_DFP/instance
  security: NON_SECURE
  type: HEADER
  userChecksum: 3DB103D2D5A500E0DAB6A4CA0EE9C25B
- generatedChecksum: 45896ABBFC6B37F766506191FFCAA89A
  logicalPath: packs/ATSAMS70N19B_DFP/component
  name: gpbr.h
  physicalPath: ../../packs/ATSAMS70N19B_DFP/component
  security: NON_SECURE
  type: HEADER
  userChecksum: 45896ABBFC6B37F766506191FFCAA89A
- generatedChecksum: F9D310700F7FDAF6ABEE631F82EDE8A1
  logicalPath: packs/ATSAMS70N19B_DFP/instance
  name: gpbr.h
  physicalPath: ../../packs/ATSAMS70N19B_DFP/instance
  security: NON_SECURE
  type: HEADER
  userChecksum: F9D310700F7FDAF6ABEE631F82EDE8A1
- generatedChecksum: 28241D86C7DC1AEBA6AEB57BE5D9E388
  logicalPath: packs/ATSAMS70N19B_DFP/component
  name: hsmci.h
  physicalPath: ../../packs/ATSAMS70N19B_DFP/component
  security: NON_SECURE
  type: HEADER
  userChecksum: 28241D86C7DC1AEBA6AEB57BE5D9E388
- generatedChecksum: E6EFC0EB2FAADB77EBD272719748CD02
  logicalPath: packs/ATSAMS70N19B_DFP/instance
  name: hsmci.h
  physicalPath: ../../packs/ATSAMS70N19B_DFP/instance
  security: NON_SECURE
  type: HEADER
  userChecksum: E6EFC0EB2FAADB77EBD272719748CD02
- generatedChecksum: CA0B1DF8272C4FC3646890169DBD7508
  logicalPath: packs/ATSAMS70N19B_DFP/component
  name: i2sc.h
  physicalPath: ../../packs/ATSAMS70N19B_DFP/component
  security: NON_SECURE
  type: HEADER
  userChecksum: CA0B1DF8272C4FC3646890169DBD7508
- generatedChecksum: A356E2680B46D08FE74DCD100C261145
  logicalPath: packs/ATSAMS70N19B_DFP/instance
  name: i2sc0.h
  physicalPath: ../../packs/ATSAMS70N19B_DFP/instance
  security: NON_SECURE
  type: HEADER
  userChecksum: A356E2680B46D08FE74DCD100C261145
- generatedChecksum: 2DD85C07E22F385AD1A982C9EAB114C4
  logicalPath: packs/ATSAMS70N19B_DFP/instance
  name: i2sc1.h
  physicalPath: ../../packs/ATSAMS70N19B_DFP/instance
  security: NON_SECURE
  type: HEADER
  userChecksum: 2DD85C07E22F385AD1A982C9EAB114C4
- generatedChecksum: B0DE2624DDB68FC77E9E13E0119F6AA4
  logicalPath: packs/ATSAMS70N19B_DFP/component
  name: icm.h
  physicalPath: ../../packs/ATSAMS70N19B_DFP/component
  security: NON_SECURE
  type: HEADER
  userChecksum: B0DE2624DDB68FC77E9E13E0119F6AA4
- generatedChecksum: 32F8841660823036BC70AB44C2CCA38A
  logicalPath: packs/ATSAMS70N19B_DFP/instance
  name: icm.h
  physicalPath: ../../packs/ATSAMS70N19B_DFP/instance
  security: NON_SECURE
  type: HEADER
  userChecksum: 32F8841660823036BC70AB44C2CCA38A
- generatedChecksum: 4F567E54227469F331ED97758002DBFB
  logicalPath: config/default
  name: interrupts.h
  physicalPath: ''
  security: NON_SECURE
  type: HEADER
  userChecksum: 4F567E54227469F331ED97758002DBFB
- generatedChecksum: B150C87F1B94B508BB8F44F5D35D03FD
  logicalPath: packs/ATSAMS70N19B_DFP/component
  name: isi.h
  physicalPath: ../../packs/ATSAMS70N19B_DFP/component
  security: NON_SECURE
  type: HEADER
  userChecksum: B150C87F1B94B508BB8F44F5D35D03FD
- generatedChecksum: 6A03EC7C6C43392E335EB0EAFE6C5857
  logicalPath: packs/ATSAMS70N19B_DFP/instance
  name: isi.h
  physicalPath: ../../packs/ATSAMS70N19B_DFP/instance
  security: NON_SECURE
  type: HEADER
  userChecksum: 6A03EC7C6C43392E335EB0EAFE6C5857
- generatedChecksum: FE17D325A06479D956285C5438994B83
  logicalPath: FreeRTOS/Source/include
  name: list.h
  physicalPath: ../../third_party/rtos/FreeRTOS/Source/include
  security: NON_SECURE
  type: HEADER
  userChecksum: FE17D325A06479D956285C5438994B83
- generatedChecksum: 64E548D61F73CDCEB781726229A885E3
  logicalPath: packs/ATSAMS70N19B_DFP/component
  name: matrix.h
  physicalPath: ../../packs/ATSAMS70N19B_DFP/component
  security: NON_SECURE
  type: HEADER
  userChecksum: 64E548D61F73CDCEB781726229A885E3
- generatedChecksum: 6E5129C007E410CCBAF63DD1BC7CB424
  logicalPath: packs/ATSAMS70N19B_DFP/instance
  name: matrix.h
  physicalPath: ../../packs/ATSAMS70N19B_DFP/instance
  security: NON_SECURE
  type: HEADER
  userChecksum: 6E5129C007E410CCBAF63DD1BC7CB424
- generatedChecksum: DDE2C9D46642D120A0202AC851E1A777
  logicalPath: FreeRTOS/Source/include
  name: message_buffer.h
  physicalPath: ../../third_party/rtos/FreeRTOS/Source/include
  security: NON_SECURE
  type: HEADER
  userChecksum: DDE2C9D46642D120A0202AC851E1A777
- generatedChecksum: 47E760D36E42A7B436306A9CB4E72A0E
  logicalPath: packs/CMSIS/CMSIS/Core/Include
  name: mpu_armv7.h
  physicalPath: ../../packs/CMSIS/CMSIS/Core/Include
  security: NON_SECURE
  type: HEADER
  userChecksum: 47E760D36E42A7B436306A9CB4E72A0E
- generatedChecksum: 2D674B8B1FCF07504AF90FA5CE2F9A23
  logicalPath: FreeRTOS/Source/include
  name: mpu_prototypes.h
  physicalPath: ../../third_party/rtos/FreeRTOS/Source/include
  security: NON_SECURE
  type: HEADER
  userChecksum: 2D674B8B1FCF07504AF90FA5CE2F9A23
- generatedChecksum: 953D372D8F7991D4F86AD4ABD42AE4CE
  logicalPath: FreeRTOS/Source/include
  name: mpu_wrappers.h
  physicalPath: ../../third_party/rtos/FreeRTOS/Source/include
  security: NON_SECURE
  type: HEADER
  userChecksum: 953D372D8F7991D4F86AD4ABD42AE4CE
- generatedChecksum: F0AD88762263B7CB89B02AB4F5876059
  logicalPath: config/default/osal
  name: osal.h
  physicalPath: osal
  security: NON_SECURE
  type: HEADER
  userChecksum: F0AD88762263B7CB89B02AB4F5876059
- generatedChecksum: 167A43EFF8A31441EBF85AC77958A30B
  logicalPath: config/default/osal
  name: osal_definitions.h
  physicalPath: osal
  security: NON_SECURE
  type: HEADER
  userChecksum: 167A43EFF8A31441EBF85AC77958A30B
- generatedChecksum: 9D6F205ECFDB2028C5CF766B52B5B7B2
  logicalPath: config/default/osal
  name: osal_freertos.h
  physicalPath: osal
  security: NON_SECURE
  type: HEADER
  userChecksum: 9D6F205ECFDB2028C5CF766B52B5B7B2
- generatedChecksum: 14AC47C98C76CAB3D8A497393455465B
  logicalPath: packs/ATSAMS70N19B_DFP/component
  name: pio.h
  physicalPath: ../../packs/ATSAMS70N19B_DFP/component
  security: NON_SECURE
  type: HEADER
  userChecksum: 14AC47C98C76CAB3D8A497393455465B
- generatedChecksum: 4E776544CF8C801B8BD629755264CFC0
  logicalPath: packs/ATSAMS70N19B_DFP/instance
  name: pioa.h
  physicalPath: ../../packs/ATSAMS70N19B_DFP/instance
  security: NON_SECURE
  type: HEADER
  userChecksum: 4E776544CF8C801B8BD629755264CFC0
- generatedChecksum: 90B88E82BF1ACF3240B8AFFB9B6E962A
  logicalPath: packs/ATSAMS70N19B_DFP/instance
  name: piob.h
  physicalPath: ../../packs/ATSAMS70N19B_DFP/instance
  security: NON_SECURE
  type: HEADER
  userChecksum: 90B88E82BF1ACF3240B8AFFB9B6E962A
- generatedChecksum: 72A2E6E24EA3207DEDE3536B0DD5AC9F
  logicalPath: packs/ATSAMS70N19B_DFP/instance
  name: pioc.h
  physicalPath: ../../packs/ATSAMS70N19B_DFP/instance
  security: NON_SECURE
  type: HEADER
  userChecksum: 72A2E6E24EA3207DEDE3536B0DD5AC9F
- generatedChecksum: 184722B994AAD2D1D9DCBEA31D10B5A0
  logicalPath: packs/ATSAMS70N19B_DFP/instance
  name: piod.h
  physicalPath: ../../packs/ATSAMS70N19B_DFP/instance
  security: NON_SECURE
  type: HEADER
  userChecksum: 184722B994AAD2D1D9DCBEA31D10B5A0
- generatedChecksum: A218817D1B0B2B77F3AD57D2486D2A72
  logicalPath: packs/ATSAMS70N19B_DFP/instance
  name: pioe.h
  physicalPath: ../../packs/ATSAMS70N19B_DFP/instance
  security: NON_SECURE
  type: HEADER
  userChecksum: A218817D1B0B2B77F3AD57D2486D2A72
- generatedChecksum: BFDB10EBEF4DBDE66563BA7DD136A98F
  logicalPath: config/default/peripheral/clk
  name: plib_clk.h
  physicalPath: peripheral/clk
  security: NON_SECURE
  type: HEADER
  userChecksum: BFDB10EBEF4DBDE66563BA7DD136A98F
- generatedChecksum: 0ABDA5C4051B45BB0C8746712B766240
  logicalPath: config/default/peripheral/efc
  name: plib_efc.h
  physicalPath: peripheral/efc
  security: NON_SECURE
  type: HEADER
  userChecksum: 0ABDA5C4051B45BB0C8746712B766240
- generatedChecksum: 72E4568BA711F287BBC99382016AE261
  logicalPath: config/default/audio/peripheral/i2sc
  name: plib_i2sc0.h
  physicalPath: audio/peripheral/i2sc
  security: NON_SECURE
  type: HEADER
  userChecksum: 72E4568BA711F287BBC99382016AE261
- generatedChecksum: 55ECCC7FA71BD15B46EF80DC0515ED7A
  logicalPath: config/default/peripheral/nvic
  name: plib_nvic.h
  physicalPath: peripheral/nvic
  security: NON_SECURE
  type: HEADER
  userChecksum: 55ECCC7FA71BD15B46EF80DC0515ED7A
- generatedChecksum: 47E27174515E65F2601F7DED2B52893A
  logicalPath: config/default/peripheral/pio
  name: plib_pio.h
  physicalPath: peripheral/pio
  security: NON_SECURE
  type: HEADER
  userChecksum: 47E27174515E65F2601F7DED2B52893A
- generatedChecksum: B48E4D6F789912A2A529067DF4FA61AC
  logicalPath: config/default/peripheral/tc
  name: plib_tc0.h
  physicalPath: peripheral/tc
  security: NON_SECURE
  type: HEADER
  userChecksum: B48E4D6F789912A2A529067DF4FA61AC
- generatedChecksum: A2F276372C68B8EE16FB32AE5DF1BE37
  logicalPath: config/default/peripheral/tc
  name: plib_tc_common.h
  physicalPath: peripheral/tc
  security: NON_SECURE
  type: HEADER
  userChecksum: A2F276372C68B8EE16FB32AE5DF1BE37
- generatedChecksum: 165F1AE43FA1838644A54F43F1A0198D
  logicalPath: config/default/peripheral/twihs/master
  name: plib_twihs0_master.h
  physicalPath: peripheral/twihs/master
  security: NON_SECURE
  type: HEADER
  userChecksum: 165F1AE43FA1838644A54F43F1A0198D
- generatedChecksum: 2C07AAF8E89B29E703A8136279BDF8C7
  logicalPath: config/default/peripheral/twihs/master
  name: plib_twihs2_master.h
  physicalPath: peripheral/twihs/master
  security: NON_SECURE
  type: HEADER
  userChecksum: 2C07AAF8E89B29E703A8136279BDF8C7
- generatedChecksum: 5132029297BC9554EFA0EC40D3C0BC74
  logicalPath: config/default/peripheral/twihs/master
  name: plib_twihs_master_common.h
  physicalPath: peripheral/twihs/master
  security: NON_SECURE
  type: HEADER
  userChecksum: 5132029297BC9554EFA0EC40D3C0BC74
- generatedChecksum: E5E0123504F9ED4652246CC99D696CC9
  logicalPath: config/default/peripheral/xdmac
  name: plib_xdmac.h
  physicalPath: peripheral/xdmac
  security: NON_SECURE
  type: HEADER
  userChecksum: E5E0123504F9ED4652246CC99D696CC9
- generatedChecksum: 2FC58EF28F630EC2CC437536C41CEDB1
  logicalPath: config/default/peripheral/xdmac
  name: plib_xdmac_common.h
  physicalPath: peripheral/xdmac
  security: NON_SECURE
  type: HEADER
  userChecksum: 2FC58EF28F630EC2CC437536C41CEDB1
- generatedChecksum: F81FDF9299540DFF03DD47D28FB5FDAF
  logicalPath: packs/ATSAMS70N19B_DFP/component
  name: pmc.h
  physicalPath: ../../packs/ATSAMS70N19B_DFP/component
  security: NON_SECURE
  type: HEADER
  userChecksum: F81FDF9299540DFF03DD47D28FB5FDAF
- generatedChecksum: 70A3C58BDAC17C1D0BAA03C69B19DC43
  logicalPath: packs/ATSAMS70N19B_DFP/instance
  name: pmc.h
  physicalPath: ../../packs/ATSAMS70N19B_DFP/instance
  security: NON_SECURE
  type: HEADER
  userChecksum: 70A3C58BDAC17C1D0BAA03C69B19DC43
- generatedChecksum: 5A686FF678CBFBB4A1FEB86B66DCEC98
  logicalPath: FreeRTOS/Source/include
  name: portable.h
  physicalPath: ../../third_party/rtos/FreeRTOS/Source/include
  security: NON_SECURE
  type: HEADER
  userChecksum: 5A686FF678CBFBB4A1FEB86B66DCEC98
- generatedChecksum: B16F3C9A1AF9C6C726871E79F424A3F9
  logicalPath: FreeRTOS/Source/portable/GCC/SAM/CM7
  name: portmacro.h
  physicalPath: ../../third_party/rtos/FreeRTOS/Source/portable/GCC/SAM/CM7
  security: NON_SECURE
  type: HEADER
  userChecksum: B16F3C9A1AF9C6C726871E79F424A3F9
- generatedChecksum: 696F66B2428CC530389C53B5FE617CE1
  logicalPath: FreeRTOS/Source/include
  name: projdefs.h
  physicalPath: ../../third_party/rtos/FreeRTOS/Source/include
  security: NON_SECURE
  type: HEADER
  userChecksum: 696F66B2428CC530389C53B5FE617CE1
- generatedChecksum: B9D23E8DB58AD4009AC42A89B03AF423
  logicalPath: packs/ATSAMS70N19B_DFP/component
  name: pwm.h
  physicalPath: ../../packs/ATSAMS70N19B_DFP/component
  security: NON_SECURE
  type: HEADER
  userChecksum: B9D23E8DB58AD4009AC42A89B03AF423
- generatedChecksum: 824D5CA2C34EE814473AF21FF04EA1CE
  logicalPath: packs/ATSAMS70N19B_DFP/instance
  name: pwm0.h
  physicalPath: ../../packs/ATSAMS70N19B_DFP/instance
  security: NON_SECURE
  type: HEADER
  userChecksum: 824D5CA2C34EE814473AF21FF04EA1CE
- generatedChecksum: F9154CB17892B823396441CF70E4D639
  logicalPath: packs/ATSAMS70N19B_DFP/instance
  name: pwm1.h
  physicalPath: ../../packs/ATSAMS70N19B_DFP/instance
  security: NON_SECURE
  type: HEADER
  userChecksum: F9154CB17892B823396441CF70E4D639
- generatedChecksum: 7D76BEE26600D2F3115910F0092F2C05
  logicalPath: packs/ATSAMS70N19B_DFP/component
  name: qspi.h
  physicalPath: ../../packs/ATSAMS70N19B_DFP/component
  security: NON_SECURE
  type: HEADER
  userChecksum: 7D76BEE26600D2F3115910F0092F2C05
- generatedChecksum: 41D20ACDF41326FBE3172FE60633B340
  logicalPath: packs/ATSAMS70N19B_DFP/instance
  name: qspi.h
  physicalPath: ../../packs/ATSAMS70N19B_DFP/instance
  security: NON_SECURE
  type: HEADER
  userChecksum: 41D20ACDF41326FBE3172FE60633B340
- generatedChecksum: 6CB1FF8C27E6755C63D75369D1D7A37A
  logicalPath: FreeRTOS/Source/include
  name: queue.h
  physicalPath: ../../third_party/rtos/FreeRTOS/Source/include
  security: NON_SECURE
  type: HEADER
  userChecksum: 6CB1FF8C27E6755C63D75369D1D7A37A
- generatedChecksum: 1CF456B03335FED53E74B3DA1A5EA159
  logicalPath: packs/ATSAMS70N19B_DFP/component
  name: rstc.h
  physicalPath: ../../packs/ATSAMS70N19B_DFP/component
  security: NON_SECURE
  type: HEADER
  userChecksum: 1CF456B03335FED53E74B3DA1A5EA159
- generatedChecksum: 6D809694768C3D3DAD67EB21068C8AB5
  logicalPath: packs/ATSAMS70N19B_DFP/instance
  name: rstc.h
  physicalPath: ../../packs/ATSAMS70N19B_DFP/instance
  security: NON_SECURE
  type: HEADER
  userChecksum: 6D809694768C3D3DAD67EB21068C8AB5
- generatedChecksum: 7D6FE57940288342E2B2AA5B640BA585
  logicalPath: packs/ATSAMS70N19B_DFP/component
  name: rswdt.h
  physicalPath: ../../packs/ATSAMS70N19B_DFP/component
  security: NON_SECURE
  type: HEADER
  userChecksum: 7D6FE57940288342E2B2AA5B640BA585
- generatedChecksum: A40C256E4EB0E2E009CFDBAD3080DAD2
  logicalPath: packs/ATSAMS70N19B_DFP/instance
  name: rswdt.h
  physicalPath: ../../packs/ATSAMS70N19B_DFP/instance
  security: NON_SECURE
  type: HEADER
  userChecksum: A40C256E4EB0E2E009CFDBAD3080DAD2
- generatedChecksum: 55CA2A1C7C5845EBB931CA5D05E5901B
  logicalPath: packs/ATSAMS70N19B_DFP/component
  name: rtc.h
  physicalPath: ../../packs/ATSAMS70N19B_DFP/component
  security: NON_SECURE
  type: HEADER
  userChecksum: 55CA2A1C7C5845EBB931CA5D05E5901B
- generatedChecksum: DFD22034FBEF83EB1EF412EF357C6539
  logicalPath: packs/ATSAMS70N19B_DFP/instance
  name: rtc.h
  physicalPath: ../../packs/ATSAMS70N19B_DFP/instance
  security: NON_SECURE
  type: HEADER
  userChecksum: DFD22034FBEF83EB1EF412EF357C6539
- generatedChecksum: 64AA8CFF3377DE92B1528906319C6324
  logicalPath: packs/ATSAMS70N19B_DFP/component
  name: rtt.h
  physicalPath: ../../packs/ATSAMS70N19B_DFP/component
  security: NON_SECURE
  type: HEADER
  userChecksum: 64AA8CFF3377DE92B1528906319C6324
- generatedChecksum: 4E5815DB31D1298DFD732ABF74A16493
  logicalPath: packs/ATSAMS70N19B_DFP/instance
  name: rtt.h
  physicalPath: ../../packs/ATSAMS70N19B_DFP/instance
  security: NON_SECURE
  type: HEADER
  userChecksum: 4E5815DB31D1298DFD732ABF74A16493
- generatedChecksum: 1D08356177A6EB5EE8B8D37F0A78F677
  logicalPath: packs/ATSAMS70N19B_DFP
  name: sams70n19b.h
  physicalPath: ../../packs/ATSAMS70N19B_DFP
  security: NON_SECURE
  type: HEADER
  userChecksum: 1D08356177A6EB5EE8B8D37F0A78F677
- generatedChecksum: 0A3D6DD077E0054CE62AB62A1B845780
  logicalPath: packs/ATSAMS70N19B_DFP/pio
  name: sams70n19b.h
  physicalPath: ../../packs/ATSAMS70N19B_DFP/pio
  security: NON_SECURE
  type: HEADER
  userChecksum: 0A3D6DD077E0054CE62AB62A1B845780
- generatedChecksum: 79E92CF89AF3667CBDEBE9FF4920FB11
  logicalPath: packs/ATSAMS70N19B_DFP/component
  name: sdramc.h
  physicalPath: ../../packs/ATSAMS70N19B_DFP/component
  security: NON_SECURE
  type: HEADER
  userChecksum: 79E92CF89AF3667CBDEBE9FF4920FB11
- generatedChecksum: B935CA3D88E7FD7C7C5EB81DC1786AB3
  logicalPath: packs/ATSAMS70N19B_DFP/instance
  name: sdramc.h
  physicalPath: ../../packs/ATSAMS70N19B_DFP/instance
  security: NON_SECURE
  type: HEADER
  userChecksum: B935CA3D88E7FD7C7C5EB81DC1786AB3
- generatedChecksum: 9F1AE7D29D09ED8CC21F3DA08049FB79
  logicalPath: FreeRTOS/Source/include
  name: semphr.h
  physicalPath: ../../third_party/rtos/FreeRTOS/Source/include
  security: NON_SECURE
  type: HEADER
  userChecksum: 9F1AE7D29D09ED8CC21F3DA08049FB79
- generatedChecksum: FDA18942F1CCE2C92AAFA6FEF5313E3A
  logicalPath: packs/ATSAMS70N19B_DFP/component
  name: smc.h
  physicalPath: ../../packs/ATSAMS70N19B_DFP/component
  security: NON_SECURE
  type: HEADER
  userChecksum: FDA18942F1CCE2C92AAFA6FEF5313E3A
- generatedChecksum: 993E497BC52003089DE4DC6419122196
  logicalPath: packs/ATSAMS70N19B_DFP/instance
  name: smc.h
  physicalPath: ../../packs/ATSAMS70N19B_DFP/instance
  security: NON_SECURE
  type: HEADER
  userChecksum: 993E497BC52003089DE4DC6419122196
- generatedChecksum: 1535F83F722982DFD6FFF1F2D0D47776
  logicalPath: packs/ATSAMS70N19B_DFP/component
  name: spi.h
  physicalPath: ../../packs/ATSAMS70N19B_DFP/component
  security: NON_SECURE
  type: HEADER
  userChecksum: 1535F83F722982DFD6FFF1F2D0D47776
- generatedChecksum: F6D3A0CB0D040D60D6465A950CD1E476
  logicalPath: packs/ATSAMS70N19B_DFP/instance
  name: spi0.h
  physicalPath: ../../packs/ATSAMS70N19B_DFP/instance
  security: NON_SECURE
  type: HEADER
  userChecksum: F6D3A0CB0D040D60D6465A950CD1E476
- generatedChecksum: 19DCBC98A424E73F755ED8F56E94E34A
  logicalPath: packs/ATSAMS70N19B_DFP/instance
  name: spi1.h
  physicalPath: ../../packs/ATSAMS70N19B_DFP/instance
  security: NON_SECURE
  type: HEADER
  userChecksum: 19DCBC98A424E73F755ED8F56E94E34A
- generatedChecksum: 810938A356F02C24407A4CFE25F7C37B
  logicalPath: packs/ATSAMS70N19B_DFP/component
  name: ssc.h
  physicalPath: ../../packs/ATSAMS70N19B_DFP/component
  security: NON_SECURE
  type: HEADER
  userChecksum: 810938A356F02C24407A4CFE25F7C37B
- generatedChecksum: CAFA42ADA67ED94FC9FFBC3BACDF3D1A
  logicalPath: packs/ATSAMS70N19B_DFP/instance
  name: ssc.h
  physicalPath: ../../packs/ATSAMS70N19B_DFP/instance
  security: NON_SECURE
  type: HEADER
  userChecksum: CAFA42ADA67ED94FC9FFBC3BACDF3D1A
- generatedChecksum: D0D11C3D2D1BD585018AE271E1AC3B8F
  logicalPath: FreeRTOS/Source/include
  name: stack_macros.h
  physicalPath: ../../third_party/rtos/FreeRTOS/Source/include
  security: NON_SECURE
  type: HEADER
  userChecksum: D0D11C3D2D1BD585018AE271E1AC3B8F
- generatedChecksum: 7C71A9D2BEF16AC21C17ED5C2452C263
  logicalPath: FreeRTOS/Source/include
  name: stream_buffer.h
  physicalPath: ../../third_party/rtos/FreeRTOS/Source/include
  security: NON_SECURE
  type: HEADER
  userChecksum: 7C71A9D2BEF16AC21C17ED5C2452C263
- generatedChecksum: 866ACA7617AEAFA3B87B84F5A7B6A647
  logicalPath: packs/ATSAMS70N19B_DFP/component
  name: supc.h
  physicalPath: ../../packs/ATSAMS70N19B_DFP/component
  security: NON_SECURE
  type: HEADER
  userChecksum: 866ACA7617AEAFA3B87B84F5A7B6A647
- generatedChecksum: C009F342078E4BC58CB4A463D75FDEF1
  logicalPath: packs/ATSAMS70N19B_DFP/instance
  name: supc.h
  physicalPath: ../../packs/ATSAMS70N19B_DFP/instance
  security: NON_SECURE
  type: HEADER
  userChecksum: C009F342078E4BC58CB4A463D75FDEF1
- generatedChecksum: AFAAF7D896D57569CA4CF73BB3339481
  logicalPath: config/default/system/cache
  name: sys_cache.h
  physicalPath: system/cache
  security: NON_SECURE
  type: HEADER
  userChecksum: AFAAF7D896D57569CA4CF73BB3339481
- generatedChecksum: 6BB6C54C5CD963A5A940CF7BB28F4E10
  logicalPath: config/default/system/debug
  name: sys_debug.h
  physicalPath: system/debug
  security: NON_SECURE
  type: HEADER
  userChecksum: 6BB6C54C5CD963A5A940CF7BB28F4E10
- generatedChecksum: 73066F5B8DD5BA7691FBF53C8DB7F681
  logicalPath: config/default/system/dma
  name: sys_dma.h
  physicalPath: system/dma
  security: NON_SECURE
  type: HEADER
  userChecksum: 73066F5B8DD5BA7691FBF53C8DB7F681
- generatedChecksum: 26D72E1E19B67D611DD99C1988AB38BC
  logicalPath: config/default/system/dma
  name: sys_dma_mapping.h
  physicalPath: system/dma
  security: NON_SECURE
  type: HEADER
  userChecksum: 26D72E1E19B67D611DD99C1988AB38BC
- generatedChecksum: 1329D2DEB6E5AC9515AD4D165C60DC74
  logicalPath: config/default/system/int
  name: sys_int.h
  physicalPath: system/int
  security: NON_SECURE
  type: HEADER
  userChecksum: 1329D2DEB6E5AC9515AD4D165C60DC74
- generatedChecksum: 00278F169FFB0CBBAB3A68B5D647F093
  logicalPath: config/default/system/int
  name: sys_int_mapping.h
  physicalPath: system/int
  security: NON_SECURE
  type: HEADER
  userChecksum: 00278F169FFB0CBBAB3A68B5D647F093
- generatedChecksum: BE95B4F134C5C929787B9DA6FDBF3501
  logicalPath: config/default/system
  name: system.h
  physicalPath: system
  security: NON_SECURE
  type: HEADER
  userChecksum: BE95B4F134C5C929787B9DA6FDBF3501
- generatedChecksum: C3F5136D520DAC4416512EBFCCA023C3
  logicalPath: config/default/system
  name: system_common.h
  physicalPath: system
  security: NON_SECURE
  type: HEADER
  userChecksum: C3F5136D520DAC4416512EBFCCA023C3
- generatedChecksum: 1C75A8A6B60598A2FD0D533F57839B72
  logicalPath: config/default/system
  name: system_module.h
  physicalPath: system
  security: NON_SECURE
  type: HEADER
  userChecksum: 1C75A8A6B60598A2FD0D533F57839B72
- generatedChecksum: 84B3224817BDD8B37961BB3B3441E134
  logicalPath: FreeRTOS/Source/include
  name: task.h
  physicalPath: ../../third_party/rtos/FreeRTOS/Source/include
  security: NON_SECURE
  type: HEADER
  userChecksum: 84B3224817BDD8B37961BB3B3441E134
- generatedChecksum: C9F84AA3259D5553C38D83D3D1ED0BD7
  logicalPath: packs/ATSAMS70N19B_DFP/component
  name: tc.h
  physicalPath: ../../packs/ATSAMS70N19B_DFP/component
  security: NON_SECURE
  type: HEADER
  userChecksum: C9F84AA3259D5553C38D83D3D1ED0BD7
- generatedChecksum: 7D27AD51534445EE7293B18FB7DACF57
  logicalPath: packs/ATSAMS70N19B_DFP/instance
  name: tc0.h
  physicalPath: ../../packs/ATSAMS70N19B_DFP/instance
  security: NON_SECURE
  type: HEADER
  userChecksum: 7D27AD51534445EE7293B18FB7DACF57
- generatedChecksum: C388C4B6F0B0B4A2B0950633ED7515D5
  logicalPath: packs/ATSAMS70N19B_DFP/instance
  name: tc1.h
  physicalPath: ../../packs/ATSAMS70N19B_DFP/instance
  security: NON_SECURE
  type: HEADER
  userChecksum: C388C4B6F0B0B4A2B0950633ED7515D5
- generatedChecksum: E55748CC679F8F9C1111FA0E56EB3CC4
  logicalPath: packs/ATSAMS70N19B_DFP/instance
  name: tc2.h
  physicalPath: ../../packs/ATSAMS70N19B_DFP/instance
  security: NON_SECURE
  type: HEADER
  userChecksum: E55748CC679F8F9C1111FA0E56EB3CC4
- generatedChecksum: 3FA2525D887A79ECE6DB0AE136CDC5DE
  logicalPath: packs/ATSAMS70N19B_DFP/instance
  name: tc3.h
  physicalPath: ../../packs/ATSAMS70N19B_DFP/instance
  security: NON_SECURE
  type: HEADER
  userChecksum: 3FA2525D887A79ECE6DB0AE136CDC5DE
- generatedChecksum: C8BB70E2423A57902E9FDC0C9EC81F8D
  logicalPath: FreeRTOS/Source/include
  name: timers.h
  physicalPath: ../../third_party/rtos/FreeRTOS/Source/include
  security: NON_SECURE
  type: HEADER
  userChecksum: C8BB70E2423A57902E9FDC0C9EC81F8D
- generatedChecksum: E7B1CC92ABE4830B5244251AB8FA4FB0
  logicalPath: config/default
  name: toolchain_specifics.h
  physicalPath: ''
  security: NON_SECURE
  type: HEADER
  userChecksum: E7B1CC92ABE4830B5244251AB8FA4FB0
- generatedChecksum: 6A84F7FEB2BDC3276E2E4B10C5743D1F
  logicalPath: packs/ATSAMS70N19B_DFP/component
  name: trng.h
  physicalPath: ../../packs/ATSAMS70N19B_DFP/component
  security: NON_SECURE
  type: HEADER
  userChecksum: 6A84F7FEB2BDC3276E2E4B10C5743D1F
- generatedChecksum: 019158918C4D735189BDA4D271A67EB5
  logicalPath: packs/ATSAMS70N19B_DFP/instance
  name: trng.h
  physicalPath: ../../packs/ATSAMS70N19B_DFP/instance
  security: NON_SECURE
  type: HEADER
  userChecksum: 019158918C4D735189BDA4D271A67EB5
- generatedChecksum: 5B42A0CC0F88CE292452600C9F0621B4
  logicalPath: packs/ATSAMS70N19B_DFP/component
  name: twihs.h
  physicalPath: ../../packs/ATSAMS70N19B_DFP/component
  security: NON_SECURE
  type: HEADER
  userChecksum: 5B42A0CC0F88CE292452600C9F0621B4
- generatedChecksum: 1360F5A8B6AE3DA0529C7FB71E126C42
  logicalPath: packs/ATSAMS70N19B_DFP/instance
  name: twihs0.h
  physicalPath: ../../packs/ATSAMS70N19B_DFP/instance
  security: NON_SECURE
  type: HEADER
  userChecksum: 1360F5A8B6AE3DA0529C7FB71E126C42
- generatedChecksum: F3739BBD47BD404960792C30F9D6070A
  logicalPath: packs/ATSAMS70N19B_DFP/instance
  name: twihs1.h
  physicalPath: ../../packs/ATSAMS70N19B_DFP/instance
  security: NON_SECURE
  type: HEADER
  userChecksum: F3739BBD47BD404960792C30F9D6070A
- generatedChecksum: C497CAC207D2AC92532A18EA9A6FC3B3
  logicalPath: packs/ATSAMS70N19B_DFP/instance
  name: twihs2.h
  physicalPath: ../../packs/ATSAMS70N19B_DFP/instance
  security: NON_SECURE
  type: HEADER
  userChecksum: C497CAC207D2AC92532A18EA9A6FC3B3
- generatedChecksum: 6DFF593708563C82204C64160E9237E1
  logicalPath: packs/ATSAMS70N19B_DFP/component
  name: uart.h
  physicalPath: ../../packs/ATSAMS70N19B_DFP/component
  security: NON_SECURE
  type: HEADER
  userChecksum: 6DFF593708563C82204C64160E9237E1
- generatedChecksum: 93DE4EBDD2583DA97683933ABF830BB4
  logicalPath: packs/ATSAMS70N19B_DFP/instance
  name: uart0.h
  physicalPath: ../../packs/ATSAMS70N19B_DFP/instance
  security: NON_SECURE
  type: HEADER
  userChecksum: 93DE4EBDD2583DA97683933ABF830BB4
- generatedChecksum: 0EFB8E68565CEA6A7748382C921083A7
  logicalPath: packs/ATSAMS70N19B_DFP/instance
  name: uart1.h
  physicalPath: ../../packs/ATSAMS70N19B_DFP/instance
  security: NON_SECURE
  type: HEADER
  userChecksum: 0EFB8E68565CEA6A7748382C921083A7
- generatedChecksum: 8524E7B01579269B716DFA2E1294EDB3
  logicalPath: packs/ATSAMS70N19B_DFP/instance
  name: uart2.h
  physicalPath: ../../packs/ATSAMS70N19B_DFP/instance
  security: NON_SECURE
  type: HEADER
  userChecksum: 8524E7B01579269B716DFA2E1294EDB3
- generatedChecksum: 936D6FBEFD1DC68B7AAEC1BDFA15B1F9
  logicalPath: packs/ATSAMS70N19B_DFP/instance
  name: uart3.h
  physicalPath: ../../packs/ATSAMS70N19B_DFP/instance
  security: NON_SECURE
  type: HEADER
  userChecksum: 936D6FBEFD1DC68B7AAEC1BDFA15B1F9
- generatedChecksum: 79CCCFF91D116CC2B47176ABB5703B58
  logicalPath: packs/ATSAMS70N19B_DFP/instance
  name: uart4.h
  physicalPath: ../../packs/ATSAMS70N19B_DFP/instance
  security: NON_SECURE
  type: HEADER
  userChecksum: 79CCCFF91D116CC2B47176ABB5703B58
- generatedChecksum: AD1F271471DF5CC93B66EA619F8B299C
  logicalPath: packs/ATSAMS70N19B_DFP/component
  name: usart.h
  physicalPath: ../../packs/ATSAMS70N19B_DFP/component
  security: NON_SECURE
  type: HEADER
  userChecksum: AD1F271471DF5CC93B66EA619F8B299C
- generatedChecksum: BB4F91F299667AE0BA7219A7B00F7345
  logicalPath: packs/ATSAMS70N19B_DFP/instance
  name: usart0.h
  physicalPath: ../../packs/ATSAMS70N19B_DFP/instance
  security: NON_SECURE
  type: HEADER
  userChecksum: BB4F91F299667AE0BA7219A7B00F7345
- generatedChecksum: F80668CA8D9A1393A1C1585C9917F38A
  logicalPath: packs/ATSAMS70N19B_DFP/instance
  name: usart1.h
  physicalPath: ../../packs/ATSAMS70N19B_DFP/instance
  security: NON_SECURE
  type: HEADER
  userChecksum: F80668CA8D9A1393A1C1585C9917F38A
- generatedChecksum: D95BC6B0FB911E1DD66E67FC984D890D
  logicalPath: packs/ATSAMS70N19B_DFP/instance
  name: usart2.h
  physicalPath: ../../packs/ATSAMS70N19B_DFP/instance
  security: NON_SECURE
  type: HEADER
  userChecksum: D95BC6B0FB911E1DD66E67FC984D890D
- generatedChecksum: DB660FFE1B6B76FE620B1777B8F3785F
  logicalPath: config/default/usb
  name: usb_audio_v2_0.h
  physicalPath: usb
  security: NON_SECURE
  type: HEADER
  userChecksum: DB660FFE1B6B76FE620B1777B8F3785F
- generatedChecksum: F698C0AF1ADC5A3E18B4832DFEAB8DB0
  logicalPath: config/default/usb
  name: usb_cdc.h
  physicalPath: usb
  security: NON_SECURE
  type: HEADER
  userChecksum: F698C0AF1ADC5A3E18B4832DFEAB8DB0
- generatedChecksum: 39659CDE2CC726544BD68544FB7EF4B2
  logicalPath: config/default/usb
  name: usb_chapter_9.h
  physicalPath: usb
  security: NON_SECURE
  type: HEADER
  userChecksum: 39659CDE2CC726544BD68544FB7EF4B2
- generatedChecksum: E7B6EAD8687A8EBC0355E0CE413B6A87
  logicalPath: config/default/usb
  name: usb_common.h
  physicalPath: usb
  security: NON_SECURE
  type: HEADER
  userChecksum: E7B6EAD8687A8EBC0355E0CE413B6A87
- generatedChecksum: 68F7DBD311EDCAF1098CDF2FD15B8C73
  logicalPath: config/default/usb
  name: usb_device.h
  physicalPath: usb
  security: NON_SECURE
  type: HEADER
  userChecksum: 68F7DBD311EDCAF1098CDF2FD15B8C73
- generatedChecksum: 2D12E3878F3119A75283C9F929AF4ECE
  logicalPath: config/default/usb
  name: usb_device_audio_v2_0.h
  physicalPath: usb
  security: NON_SECURE
  type: HEADER
  userChecksum: 2D12E3878F3119A75283C9F929AF4ECE
- generatedChecksum: F1845ADBB1B058BF485F38E2C41FE7EA
  logicalPath: config/default/usb/src
  name: usb_device_audio_v2_local.h
  physicalPath: usb/src
  security: NON_SECURE
  type: HEADER
  userChecksum: F1845ADBB1B058BF485F38E2C41FE7EA
- generatedChecksum: EE6F55EAA31844DFFD1822493E3BE0FF
  logicalPath: config/default/usb
  name: usb_device_cdc.h
  physicalPath: usb
  security: NON_SECURE
  type: HEADER
  userChecksum: EE6F55EAA31844DFFD1822493E3BE0FF
- generatedChecksum: A8E75B653DC44962608C0013C17A01F7
  logicalPath: config/default/usb/src
  name: usb_device_cdc_local.h
  physicalPath: usb/src
  security: NON_SECURE
  type: HEADER
  userChecksum: A8E75B653DC44962608C0013C17A01F7
- generatedChecksum: 626BFDDD140B808E90C9DD2E4A27421E
  logicalPath: config/default/usb/src
  name: usb_device_function_driver.h
  physicalPath: usb/src
  security: NON_SECURE
  type: HEADER
  userChecksum: 626BFDDD140B808E90C9DD2E4A27421E
- generatedChecksum: 9B727D396CAEBD5FCB12F1F8264C4FD9
  logicalPath: config/default/usb/src
  name: usb_device_local.h
  physicalPath: usb/src
  security: NON_SECURE
  type: HEADER
  userChecksum: 9B727D396CAEBD5FCB12F1F8264C4FD9
- generatedChecksum: C8D4A1D9092FD842506F565CE9B8C265
  logicalPath: config/default/usb/src
  name: usb_device_mapping.h
  physicalPath: usb/src
  security: NON_SECURE
  type: HEADER
  userChecksum: C8D4A1D9092FD842506F565CE9B8C265
- generatedChecksum: 6C4A6859DB16EA8C046F995C6B6C1C6F
  logicalPath: config/default/usb/src
  name: usb_external_dependencies.h
  physicalPath: usb/src
  security: NON_SECURE
  type: HEADER
  userChecksum: 6C4A6859DB16EA8C046F995C6B6C1C6F
- generatedChecksum: 6EB8F9F4A43B9BC2C7A58585AC679650
  logicalPath: config/default/usb
  name: usb_host.h
  physicalPath: usb
  security: NON_SECURE
  type: HEADER
  userChecksum: 6EB8F9F4A43B9BC2C7A58585AC679650
- generatedChecksum: 6EBC5E4D06FC96A02ADF3B7416957DD6
  logicalPath: config/default/usb
  name: usb_host_client_driver.h
  physicalPath: usb
  security: NON_SECURE
  type: HEADER
  userChecksum: 6EBC5E4D06FC96A02ADF3B7416957DD6
- generatedChecksum: 757C8484C955543C893361992D11FD4C
  logicalPath: config/default/usb
  name: usb_host_hub_interface.h
  physicalPath: usb
  security: NON_SECURE
  type: HEADER
  userChecksum: 757C8484C955543C893361992D11FD4C
- generatedChecksum: 3E3CC6BC9128194CB4D19F29C57E312B
  logicalPath: config/default/usb
  name: usb_hub.h
  physicalPath: usb
  security: NON_SECURE
  type: HEADER
  userChecksum: 3E3CC6BC9128194CB4D19F29C57E312B
- generatedChecksum: 638811E07E6FF67E28744A770F545D79
  logicalPath: packs/ATSAMS70N19B_DFP/component
  name: usbhs.h
  physicalPath: ../../packs/ATSAMS70N19B_DFP/component
  security: NON_SECURE
  type: HEADER
  userChecksum: 638811E07E6FF67E28744A770F545D79
- generatedChecksum: 63A4C475C6C48CE502D1AA291C85D02F
  logicalPath: packs/ATSAMS70N19B_DFP/instance
  name: usbhs.h
  physicalPath: ../../packs/ATSAMS70N19B_DFP/instance
  security: NON_SECURE
  type: HEADER
  userChecksum: 63A4C475C6C48CE502D1AA291C85D02F
- generatedChecksum: null
  logicalPath: config/default
  name: user.h
  physicalPath: ''
  security: NON_SECURE
  type: HEADER
  userChecksum: null
- generatedChecksum: 2726141F83DB8F0DF0C1721840EAB242
  logicalPath: packs/ATSAMS70N19B_DFP/component
  name: utmi.h
  physicalPath: ../../packs/ATSAMS70N19B_DFP/component
  security: NON_SECURE
  type: HEADER
  userChecksum: 2726141F83DB8F0DF0C1721840EAB242
- generatedChecksum: B262B734804D5C3420D7F7D323CA5DD6
  logicalPath: packs/ATSAMS70N19B_DFP/instance
  name: utmi.h
  physicalPath: ../../packs/ATSAMS70N19B_DFP/instance
  security: NON_SECURE
  type: HEADER
  userChecksum: B262B734804D5C3420D7F7D323CA5DD6
- generatedChecksum: AA4CA3E5FBBBA977847EC56E77F79A67
  logicalPath: packs/ATSAMS70N19B_DFP/component
  name: wdt.h
  physicalPath: ../../packs/ATSAMS70N19B_DFP/component
  security: NON_SECURE
  type: HEADER
  userChecksum: AA4CA3E5FBBBA977847EC56E77F79A67
- generatedChecksum: A6B86B878C2F697E826F84EFC941ED4A
  logicalPath: packs/ATSAMS70N19B_DFP/instance
  name: wdt.h
  physicalPath: ../../packs/ATSAMS70N19B_DFP/instance
  security: NON_SECURE
  type: HEADER
  userChecksum: A6B86B878C2F697E826F84EFC941ED4A
- generatedChecksum: 4A6E57F5B6A12C30439B12C37BE9990F
  logicalPath: packs/ATSAMS70N19B_DFP/component
  name: xdmac.h
  physicalPath: ../../packs/ATSAMS70N19B_DFP/component
  security: NON_SECURE
  type: HEADER
  userChecksum: 4A6E57F5B6A12C30439B12C37BE9990F
- generatedChecksum: D413E2A38C813D5220EED14D9C2CF01B
  logicalPath: packs/ATSAMS70N19B_DFP/instance
  name: xdmac.h
  physicalPath: ../../packs/ATSAMS70N19B_DFP/instance
  security: NON_SECURE
  type: HEADER
  userChecksum: D413E2A38C813D5220EED14D9C2CF01B
- generatedChecksum: D36C903C05BC845FAD325C8C7A6684B4
  logicalPath: config/default
  name: ATSAMS70N19B.ld
  physicalPath: ''
  security: NON_SECURE
  type: LINKER
  userChecksum: D36C903C05BC845FAD325C8C7A6684B4
format_version: v1.0
libraries: []
settings:
- append: true
  category: C32
  delimiter: ;
  key: extra-include-directories
  security: NON_SECURE
  value: ../src/third_party/rtos/FreeRTOS/Source/include;
- append: true
  category: C32
  delimiter: ;
  key: extra-include-directories
  security: NON_SECURE
  value: ../src/third_party/rtos/FreeRTOS/Source/portable/GCC/SAM/CM7;
- append: true
  category: C32
  delimiter: ;
  key: extra-include-directories
  security: NON_SECURE
  value: ../src;../src/config/default;../src/packs/ATSAMS70N19B_DFP;../src/packs/CMSIS/CMSIS/Core/Include;../src/packs/CMSIS/
- append: false
  category: C32-LD
  delimiter: ''
  key: heap-size
  security: NON_SECURE
  value: '512'
- append: false
  category: C32-LD
  delimiter: ''
  key: no-device-startup-code
  security: NON_SECURE
  value: 'true'
- append: true
  category: C32-LD
  delimiter: ;=
  key: preprocessor-macros
  security: NON_SECURE
  value: ''
- append: true
  category: C32CPP
  delimiter: ;
  key: extra-include-directories
  security: NON_SECURE
  value: ../src/third_party/rtos/FreeRTOS/Source/include;../src/third_party/rtos/FreeRTOS/Source/portable/GCC/SAM/CM7;
- append: true
  category: C32CPP
  delimiter: ;
  key: extra-include-directories
  security: NON_SECURE
  value: ../src;../src/config/default;../src/packs/ATSAMS70N19B_DFP;../src/packs/CMSIS/CMSIS/Core/Include;../src/packs/CMSIS/
- append: false
  category: C32Global
  delimiter: ''
  key: mdtcm
  security: NON_SECURE
  value: ''
- append: false
  category: C32Global
  delimiter: ''
  key: mitcm
  security: NON_SECURE
  value: ''
- append: false
  category: C32Global
  delimiter: ''
  key: mstacktcm
  security: NON_SECURE
  value: 'false'
sourcePaths: []
