stefantquach/steDAC/firmware/firmware/src/config/default/initialization.c

/*******************************************************************************
  System Initialization File

  File Name:
    initialization.c

  Summary:
    This file contains source code necessary to initialize the system.

  Description:
    This file contains source code necessary to initialize the system.  It
    implements the "SYS_Initialize" function, defines the configuration bits,
    and allocates any necessary global system resources,
 *******************************************************************************/

// DOM-IGNORE-BEGIN
/*******************************************************************************
* Copyright (C) 2018 Microchip Technology Inc. and its subsidiaries.
*
* Subject to your compliance with these terms, you may use Microchip software
* and any derivatives exclusively with Microchip products. It is your
* responsibility to comply with third party license terms applicable to your
* use of third party software (including open source software) that may
* accompany Microchip software.
*
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
* IN NO EVENT WILL MICROCHIP BE LIABLE FOR ANY INDIRECT, SPECIAL, PUNITIVE,
* INCIDENTAL OR CONSEQUENTIAL LOSS, DAMAGE, COST OR EXPENSE OF ANY KIND
* WHATSOEVER RELATED TO THE SOFTWARE, HOWEVER CAUSED, EVEN IF MICROCHIP HAS
* BEEN ADVISED OF THE POSSIBILITY OR THE DAMAGES ARE FORESEEABLE. TO THE
* FULLEST EXTENT ALLOWED BY LAW, MICROCHIP'S TOTAL LIABILITY ON ALL CLAIMS IN
* ANY WAY RELATED TO THIS SOFTWARE WILL NOT EXCEED THE AMOUNT OF FEES, IF ANY,
* THAT YOU HAVE PAID DIRECTLY TO MICROCHIP FOR THIS SOFTWARE.
 *******************************************************************************/
// DOM-IGNORE-END

// *****************************************************************************
// *****************************************************************************
// Section: Included Files
// *****************************************************************************
// *****************************************************************************
#include "configuration.h"
#include "definitions.h"
#include "device.h"



// ****************************************************************************
// ****************************************************************************
// Section: Configuration Bits
// ****************************************************************************
// ****************************************************************************
#pragma config TCM_CONFIGURATION = 0
#pragma config SECURITY_BIT = CLEAR
#pragma config BOOT_MODE = SET




// *****************************************************************************
// *****************************************************************************
// Section: Driver Initialization Data
// *****************************************************************************
// *****************************************************************************
// <editor-fold defaultstate="collapsed" desc="DRV_I2S Instance 0 Initialization Data">

/* I2S PLIB Interface Initialization */
DRV_I2S_PLIB_INTERFACE drvI2S0PlibAPI =
{
    .I2S_LRCLK_Get = (DRV_I2S_LRCLK_GET)I2SC0_LRCLK_Get,  
};

/* I2S Driver Initialization Data */
DRV_I2S_INIT drvI2S0InitData =
{
    /* I2S PLIB API */
    .i2sPlib = &drvI2S0PlibAPI,

    /* I2S IRQ */
    .interruptI2S = DRV_I2S_INT_SRC_IDX0,

    /* I2S Number of clients */
    .numClients = DRV_I2S_CLIENTS_NUMBER_IDX0,

    /* I2S Queue Size */
    .queueSize = DRV_I2S_QUEUE_SIZE_IDX0,  

    .dmaChannelTransmit = DRV_I2S_XMIT_DMA_CH_IDX0,
    .dmaChannelReceive  = DRV_I2S_RCV_DMA_CH_IDX0,
    .i2sTransmitAddress = (void *)&(I2SC0_REGS->I2SC_THR),
    .i2sReceiveAddress = (void *)&(I2SC0_REGS->I2SC_RHR),

    /************ code specific to SAM E70 ********************/
    .interruptDMA = XDMAC_IRQn,
    /************ code specific to SAM E70 ********************/
    .dmaDataLength = DRV_I2S_DATA_LENGTH_IDX0,
};

// </editor-fold>



// *****************************************************************************
// *****************************************************************************
// Section: System Data
// *****************************************************************************
// *****************************************************************************
/* Structure to hold the object handles for the modules in the system. */
SYSTEM_OBJECTS sysObj;

// *****************************************************************************
// *****************************************************************************
// Section: Library/Stack Initialization Data
// *****************************************************************************
// *****************************************************************************
/******************************************************
 * USB Driver Initialization
 ******************************************************/
 

const DRV_USBHSV1_INIT drvUSBInit =
{
    /* Interrupt Source for USB module */
    .interruptSource = USBHS_IRQn,

    /* System module initialization */
    .moduleInit = {0},

    /* USB Controller to operate as USB Device */
    .operationMode = DRV_USBHSV1_OPMODE_DEVICE,

    /* To operate in USB Normal Mode */
    .operationSpeed = DRV_USBHSV1_DEVICE_SPEEDCONF_NORMAL,

    /* Identifies peripheral (PLIB-level) ID */
    .usbID = USBHS_REGS,
	
};




// *****************************************************************************
// *****************************************************************************
// Section: System Initialization
// *****************************************************************************
// *****************************************************************************



// *****************************************************************************
// *****************************************************************************
// Section: Local initialization functions
// *****************************************************************************
// *****************************************************************************



/*******************************************************************************
  Function:
    void SYS_Initialize ( void *data )

  Summary:
    Initializes the board, services, drivers, application and other modules.

  Remarks:
 */

void SYS_Initialize ( void* data )
{


    EFC_Initialize();
  
    CLOCK_Initialize();
	PIO_Initialize();



    XDMAC_Initialize();

	RSWDT_REGS->RSWDT_MR = RSWDT_MR_WDDIS_Msk;	// Disable RSWDT 

	WDT_REGS->WDT_MR = WDT_MR_WDDIS_Msk; 		// Disable WDT 

  

 
    TC0_CH0_TimerInitialize(); 
     
    
	TWIHS0_Initialize();

    I2SC0_Initialize();
	TWIHS2_Initialize();


    /* Initialize I2S0 Driver Instance */
    sysObj.drvI2S0 = DRV_I2S_Initialize(DRV_I2S_INDEX_0, (SYS_MODULE_INIT *)&drvI2S0InitData);




	 /* Initialize the USB device layer */
    sysObj.usbDevObject0 = USB_DEVICE_Initialize (USB_DEVICE_INDEX_0 , ( SYS_MODULE_INIT* ) & usbDevInitData);
	
	

	/* Initialize USB Driver */ 
    sysObj.drvUSBHSV1Object = DRV_USBHSV1_Initialize(DRV_USBHSV1_INDEX_0, (SYS_MODULE_INIT *) &drvUSBInit);	


    APP_Initialize();


    NVIC_Initialize();

}


/*******************************************************************************
 End of File
*/
