stefantquach/steDAC/(commit log)

2022-01-11 Initial commit of AK4493 connections
    [steDAC.kicad_pcb, steDAC.kicad_sch]
2022-02-07 Adding Initial MCU configuration
    [AK4493_sch.kicad_sch, MCU_sch.kicad_sch, steDAC.kicad_sch]
2022-02-12 Adding ES9038 parts
    [DAC_interface.kicad_sch, steDAC.kicad_sch]
2022-02-14 Adding ES9038q2m configuration
    [DAC_interface.kicad_sch, steDAC.kicad_sch]
2022-02-20 WIP output stage
    [DAC_interface.kicad_sch, MCU_sch.kicad_sch, output_stage.kicad_sch, power.kicad_sch, steDAC.kicad_sch]
2022-02-27 Adding values to output stage
    [DAC_interface.kicad_sch, MCU_sch.kicad_sch, connectors.kicad_sch, output_stage.kicad_sch, power.kicad_sch, steDAC.kicad_sch]
2022-03-03 Redoing power stage and changing output stage accordingly
    [MCU_sch.kicad_sch, connectors.kicad_sch, output_stage.kicad_sch, power.kicad_sch, steDAC.kicad_sch]
2022-03-05 Finishing MCU interface. Adding connectors
    [MCU_sch.kicad_sch, connectors.kicad_sch, output_stage.kicad_sch, steDAC.kicad_sch]
2022-03-06 Adding MCU LED
    [MCU_sch.kicad_sch]
2022-04-10 Finishing Schematic. Fixed ERC errors
    [DAC_interface.kicad_sch, MCU_sch.kicad_sch, connectors.kicad_sch, output_stage.kicad_sch, power.kicad_sch, steDAC.kicad_sch]
2022-04-10 Adding footprints
    [DAC_interface.kicad_sch, MCU_sch.kicad_sch, connectors.kicad_sch, output_stage.kicad_sch, power.kicad_sch, steDAC.kicad_sch]
2022-04-24 Adding footprints. WIP PCB, finished routing, no ground planes yet
    [DAC_interface.kicad_sch, connectors.kicad_sch, output_stage.kicad_sch, power.kicad_sch, steDAC.kicad_pcb, steDAC.kicad_sch]
2022-04-24 Adding some missing nets
    [steDAC.kicad_pcb]
2022-04-24 Moving some traces around
    [steDAC.kicad_pcb]
2022-04-24 Updating pcb design
    [steDAC.kicad_pcb]
2022-04-25 Finishing routing and ground planes
    [MCU_sch.kicad_sch, connectors.kicad_sch, power.kicad_sch, steDAC.kicad_pcb]
2022-04-25 Updating PCB schematic DRC
    [steDAC.kicad_pcb]
2022-05-09 Adding part numbers for passives
    [DAC_interface.kicad_sch, MCU_sch.kicad_sch, connectors.kicad_sch, output_stage.kicad_sch, power.kicad_sch, steDAC.kicad_pcb, steDAC.kicad_sch]
2022-05-09 Adding more part numbers. WIP verifying part numbers
    [DAC_interface.kicad_sch, connectors.kicad_sch, output_stage.kicad_sch, power.kicad_sch, steDAC.kicad_sch]
2022-05-11 Adding logos and finish up bom
    [DAC_interface.kicad_sch, power.kicad_sch, steDAC.csv, steDAC.kicad_pcb]
2022-05-11 Adding readme
    [power.kicad_sch, steDAC.csv, steDAC.kicad_sch]
2022-05-11 Moving USB closer to edge. Adding silkscreen text for ERASE and JTAG_SEL. Updating README
    [steDAC.kicad_pcb]
2022-05-12 Fixing some via sizes
    [steDAC.kicad_pcb]
2022-05-12 Updating stuff
    [MCU_sch.kicad_sch, steDAC.kicad_pcb, steDAC.kicad_sch]
2022-05-14 Changing negative rail power supply
    [MCU_sch.kicad_sch, connectors.kicad_sch, power.kicad_sch, steDAC.csv, steDAC.kicad_pcb, steDAC.kicad_sch]
2022-05-14 Trace edits
    [steDAC.kicad_pcb]
2022-05-18 Adding pdf version of schematic
2022-05-19 Adding pcb pdfs
    [steDAC.kicad_pcb]
2022-05-20 Adding gerbers
    [steDAC-B_Cu.gbl, steDAC-B_Mask.gbs, steDAC-B_Paste.gbp, steDAC-B_Silkscreen.gbo, steDAC-Edge_Cuts.gm1, steDAC-F_Cu.gtl, steDAC-F_Mask.gts, steDAC-F_Paste.gtp]
2022-05-31 Updating BOM generator script
    [steDAC.csv, steDAC.kicad_pcb]
2022-06-07 [REV1.0.1] Rerouting some traces in the output stage. Adding rev1.0.1 gerbers
    [steDAC-B_Cu.gbl, steDAC-B_Mask.gbs, steDAC-B_Paste.gbp, steDAC-B_Silkscreen.gbo, steDAC-Edge_Cuts.gm1, steDAC-F_Cu.gtl, steDAC-F_Mask.gts, steDAC-F_Paste.gtp]
2022-07-02 REV 1.0.1 does not work. Updating BOM IDs.
    [DAC_interface.kicad_sch, power.kicad_sch]
2022-07-03 Fixing 3.3V being fed to VDDCORE. Swaping 3.3V LDOs to onsemi ones with higher output current
    [DAC_interface.kicad_sch, MCU_sch.kicad_sch, connectors.kicad_sch, output_stage.kicad_sch, power.kicad_sch, steDAC.kicad_pcb, steDAC.kicad_sch]
2022-07-04 Updating gerbers, schematics and BOM for Rev 1.1.0
    [steDAC-B_Cu.gbl, steDAC-B_Mask.gbs, steDAC-B_Paste.gbp, steDAC-B_Silkscreen.gbo, steDAC-Edge_Cuts.gm1, steDAC-F_Cu.gtl, steDAC-F_Mask.gts, steDAC-F_Paste.gtp]
2022-07-17 Adding stuff for rev 2.0
    [DAC_interface.kicad_sch, MCU_sch.kicad_sch, back_panel2_colored.dxf, configuration.h, connectors.kicad_sch, front_panel2_colored.dxf, output_stage.kicad_sch, power.kicad_sch]
2022-07-19 Adding updated schematic PDF and BOM
    [steDAC.csv]
